gianlucarenzi/Vera-Module-RBL-A2/VGA-Extender/images/VGA-Extender-BOTTOM.png

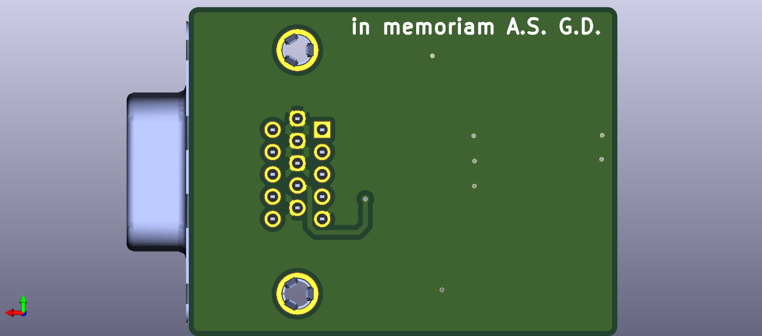
VGA-Extender/images/VGA-Extender-BOTTOM.png
