gianlucarenzi/Vera-Module-RBL-A2/VGA-Extender/images/VGA-Extender-TOP.png

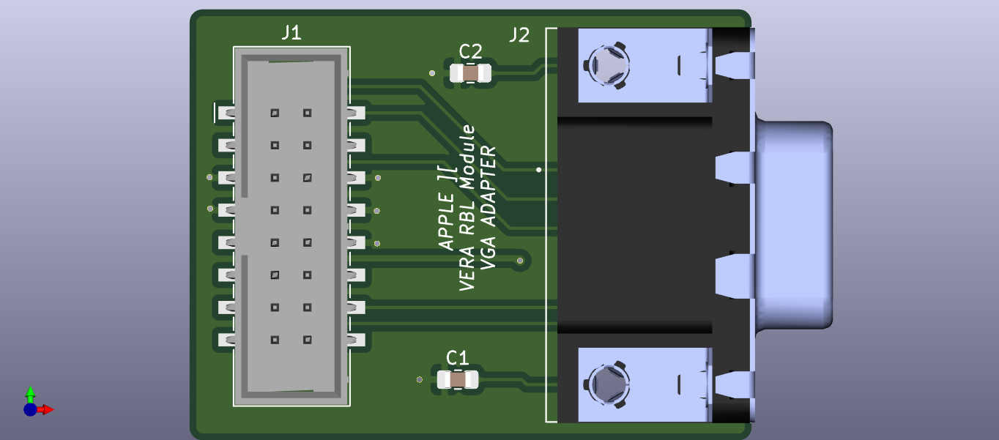
VGA-Extender/images/VGA-Extender-TOP.png
