gianlucarenzi/Vera-Module-RBL-A2/VGA-Extender/images/VGA-Extender.png

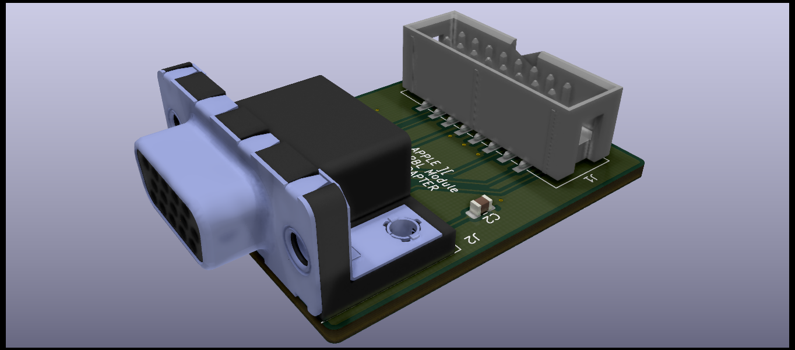
VGA-Extender/images/VGA-Extender.png
