gianlucarenzi/Vera-Module-RBL-A2/VERA-MODULE-RBL.csv

Comment | Designator | Footprint | LCSC
10uF | C13,C15,C17,C19,C21,C24 | Capacitor_SMD:C_0805_2012Metric_Pad1.18x1.45mm_HandSolder | C440198
100nF | C1,C2,C9,C10,C11,C12,C14,C16,C18,C20,C22,C23,C27,C28,C29,C38,C40,C42,C44,C46,C49,C50,C52,C57,C58,C61,C62,C63,C67,C68,C69,C70 | Capacitor_SMD:C_0805_2012Metric_Pad1.18x1.45mm_HandSolder | C840116
4.7uF | C26,C34,C35 | Capacitor_SMD:C_0805_2012Metric_Pad1.18x1.45mm_HandSolder | C7393930
2.2uF | C36 | Capacitor_SMD:C_0805_2012Metric_Pad1.18x1.45mm_HandSolder | C377773
22uF | C37 | Capacitor_SMD:C_0805_2012Metric_Pad1.18x1.45mm_HandSolder | C86817
1uF | C3,C4,C5,C6,C7,C8,C25,C30,C31,C32,C33,C43,C59,C60 | Capacitor_SMD:C_0805_2012Metric_Pad1.18x1.45mm_HandSolder | C2798196
10uF-35V | C47 | Capacitor_Tantalum_SMD:CP_EIA-3528-12_Kemet-T_Pad1.50x2.35mm_HandSolder | C8017
10uF-20V | C45,C48,C51 | Capacitor_Tantalum_SMD:CP_EIA-3528-12_Kemet-T_Pad1.50x2.35mm_HandSolder | C8017
27pF | C64,C65 | Capacitor_SMD:C_0805_2012Metric_Pad1.18x1.45mm_HandSolder | C1808
DIOSCH20V | D3,D4 | Diode_SMD:D_SMC_Handsoldering | C236151
Fiducial | FID1,FID2,FID3,FID4 | Fiducial:Fiducial_0.5mm_Mask1mm
MountingHole | H1,H2,H3,H4 | MountingHole:MountingHole_3.2mm_M3
CONN_SMD_HEADER_BOX_02x08_HX-JN2.54 | J1,J2 | RetroBitLab:IDC-Header_2x08_P2.54mm_Vertical_SMD | C41376031
CONN_DM3AT-SF-PEJM5 | J3 | RetroBitLab:HRS_DM3AT-SF-PEJM5 | C114218
DX07S016JA1R1500 | J4 | RetroBitLab:JAE_DX07S016JA1R1500 | C3197885
PJ-002AH-SMT-TR | J5 | RetroBitLab:CUI_PJ-002AH-SMT-TR | C22434687
CONN_SMD_01x08_Staggered_2.54mm | J6 | Connector_PinSocket_2.54mm:PinSocket_1x08_P2.54mm_Vertical_SMD_Pin1Right | C42380985
PJ-313D | J7 | RetroBitLab:jack_3.5_pj313d-smt | C668608
Bus_Apple_II_Card_Side | J8 | RetroBitLab:APPLE2-PERIPHERAL-BUS-EDGE
SolderJumper_2_Open | JP1,JP3 | Jumper:SolderJumper-2_P1.3mm_Open_RoundedPad1.0x1.5mm
Jumper_2_Open | JP2 | Connector_PinHeader_2.54mm:PinHeader_1x02_P2.54mm_Vertical
FB0805100R100MHZ4A | L1 | Inductor_SMD:L_0805_2012Metric_Pad1.15x1.40mm_HandSolder | C15957
IND0603600R100MHZ300mA | L2 | Inductor_SMD:L_0603_1608Metric_Pad1.05x0.95mm_HandSolder | C139271
Label-20mmx10mm | LBL1 | RetroBitLab:Label-20mmx10mm-Silkscreen
RED | LD1,LD3,LD5 | LED_SMD:LED_1206_3216Metric_Pad1.42x1.75mm_HandSolder | C965822
GREEN | LD2,LD4 | LED_SMD:LED_0805_2012Metric_Pad1.15x1.40mm_HandSolder | C84260
VERA X16 LOGO | LOGO1 | RetroBitLab:x16logo
RETROCAMPUS | LOGO2 | RetroBitLab:retrocampus_silkscreen_16.9mm_8.3mm
KiCAD DESIGN | LOGO3 | Symbol:KiCad-Logo2_6mm_SilkScreen
ESP32_BOBOARD | LOGO5 | RetroBitLab:ESP32_BOBOARD_5V_21.7mmx21.7mm
MOSFET-BSS138-SOT-23 | Q1 | Package_TO_SOT_SMD:SOT-23 | C82045
BC817,SOT-23 | Q3,Q4 | Package_TO_SOT_SMD:SOT-23 | C20069154
2K7 | R1 | Resistor_SMD:R_0805_2012Metric_Pad1.20x1.40mm_HandSolder | C313926
2K | R11,R13,R15 | Resistor_SMD:R_0805_2012Metric_Pad1.20x1.40mm_HandSolder | C114572
150R | R12,R14,R16 | Resistor_SMD:R_0805_2012Metric_Pad1.20x1.40mm_HandSolder | C17471
160R | R18,R20,R22 | Resistor_SMD:R_0805_2012Metric_Pad1.20x1.40mm_HandSolder | C2960793
910R | R17,R19,R21 | Resistor_SMD:R_0805_2012Metric_Pad1.20x1.40mm_HandSolder | C2930211
27R | R24,R26,R28 | Resistor_SMD:R_0805_2012Metric_Pad1.20x1.40mm_HandSolder | C17594
820R | R29,R30 | Resistor_SMD:R_0805_2012Metric_Pad1.20x1.40mm_HandSolder | C17837
50R | R3,R4 | Resistor_SMD:R_0805_2012Metric_Pad1.20x1.40mm_HandSolder | C2828866
330R | R32,R61 | Resistor_SMD:R_0805_2012Metric_Pad1.20x1.40mm_HandSolder | C313892
47K | R37,R38,R39,R40,R41,R42,R43,R44 | Resistor_SMD:R_0805_2012Metric_Pad1.20x1.40mm_HandSolder | C17713
560R | R45,R46,R67,R68 | Resistor_SMD:R_0805_2012Metric_Pad1.20x1.40mm_HandSolder | C28636
DNP | R49 | Resistor_SMD:R_1206_3216Metric_Pad1.30x1.75mm_HandSolder
10K | R5,R7,R34,R36,R47,R48,R53,R62,R63,R65,R69,R70,R71 | Resistor_SMD:R_0805_2012Metric_Pad1.20x1.40mm_HandSolder | C84376
5K1 | R50,R51 | Resistor_SMD:R_0805_2012Metric_Pad1.20x1.40mm_HandSolder | C27834
220R | R54 | Resistor_SMD:R_0805_2012Metric_Pad1.20x1.40mm_HandSolder | C5120092
2K2 | R52,R55 | Resistor_SMD:R_0805_2012Metric_Pad1.20x1.40mm_HandSolder | C17520
510R | R23,R25,R27,R57 | Resistor_SMD:R_0805_2012Metric_Pad1.20x1.40mm_HandSolder | C114563
330R | R58 | Resistor_SMD:R_0603_1608Metric_Pad0.98x0.95mm_HandSolder | C105881
4K7 | R31,R33,R59,R60 | Resistor_SMD:R_0805_2012Metric_Pad1.20x1.40mm_HandSolder | C17673
CREZ08051% | R2,R35,R56,R64,R72,R73,R74 | Resistor_SMD:R_0805_2012Metric_Pad1.20x1.40mm_HandSolder | C328378
4K3 | R8,R9,R10 | Resistor_SMD:R_0805_2012Metric_Pad1.20x1.40mm_HandSolder | C17667
SPST2P | SW1,SW3 | RetroBitLab:SPST-7.3x3.9x2.5-WUERTH-434121025816 | C318911
TP5V | TP1 | TestPoint:TestPoint_Pad_D2.0mm
W25Q16JVSNIQ | U10 | Package_SO:SOIC-8_3.9x4.9mm_P1.27mm | C2456211
WM8524CGEDT | U11 | Package_SO:TSSOP-16_4.4x5mm_P0.65mm | C146242
USBCH340C | U12 | RetroBitLab:SOIC-16_3.9x9.9mm_P1.27mm | C84681
AMS1117-3.3 | U13 | Package_TO_SOT_SMD:SOT-223-3_TabPin2 | C6186
AMS1117-1.2 | U14 | Package_TO_SOT_SMD:SOT-223-3_TabPin2 | C347218
L7805 | U15 | Package_TO_SOT_SMD:TO-252-2 | C110908
MAX40200AUK | U17,U18 | Package_TO_SOT_SMD:SOT-23-5 | C47118006
ICE40UP5K-SG48ITR | U2 | RetroBitLab:QFN-48-1EP_7x7mm_P0.5mm_EP5.6x5.6mm | C2678152
SN74HCT04DR | U23 | Package_SO:SOIC-14_3.9x8.7mm_P1.27mm | C6766
SN74LVC00 | U24,U25 | Package_SO:TSSOP-14_4.4x5mm_P0.65mm | C7803
SN74LVC1G07DBVR | U26,U27 | Package_TO_SOT_SMD:SOT-23-5 | C7829
74LVC4245APW_118 | U3,U4,U6,U19 | RetroBitLab:IC_74LVC4245_SOP65P640X110-24N | C6091
IC74HC00 | U5 | Package_SO:SOIC-14_3.9x8.7mm_P1.27mm | C5586
ESP32-S3FN8 | U7 | RetroBitLab:IC_ESP32-S3FN8-QFN40P700X700X90-57N | C2913196
74CBTLV3126PW,118 | U8 | Package_SO:TSSOP-14_4.4x5mm_P0.65mm | C543078
CD4011B | U9 | Package_SO:SOIC-14_3.9x8.7mm_P1.27mm | C194334
OT3EL89CJI-111YLC-25M | X1 | RetroBitLab:OSC_ECS-2033-250-BN | C7471623
40.000Mhz | Y2 | Crystal:Crystal_SMD_2520-4Pin_2.5x2.0mm | C284176
TestPoint | mIOSEL1 | TestPoint:TestPoint_Pad_D2.0mm
