gianlucarenzi/Vera-Module-RBL-A2/(list of files, cad)

Other CAD files:
images/VERA-MODULE-RBL.step
