gianlucarenzi/Vera-Module-RBL-A2/VERA-MODULE-RBL.pdf

## Sheet: VeraModule

## Sheet: BusDecoder

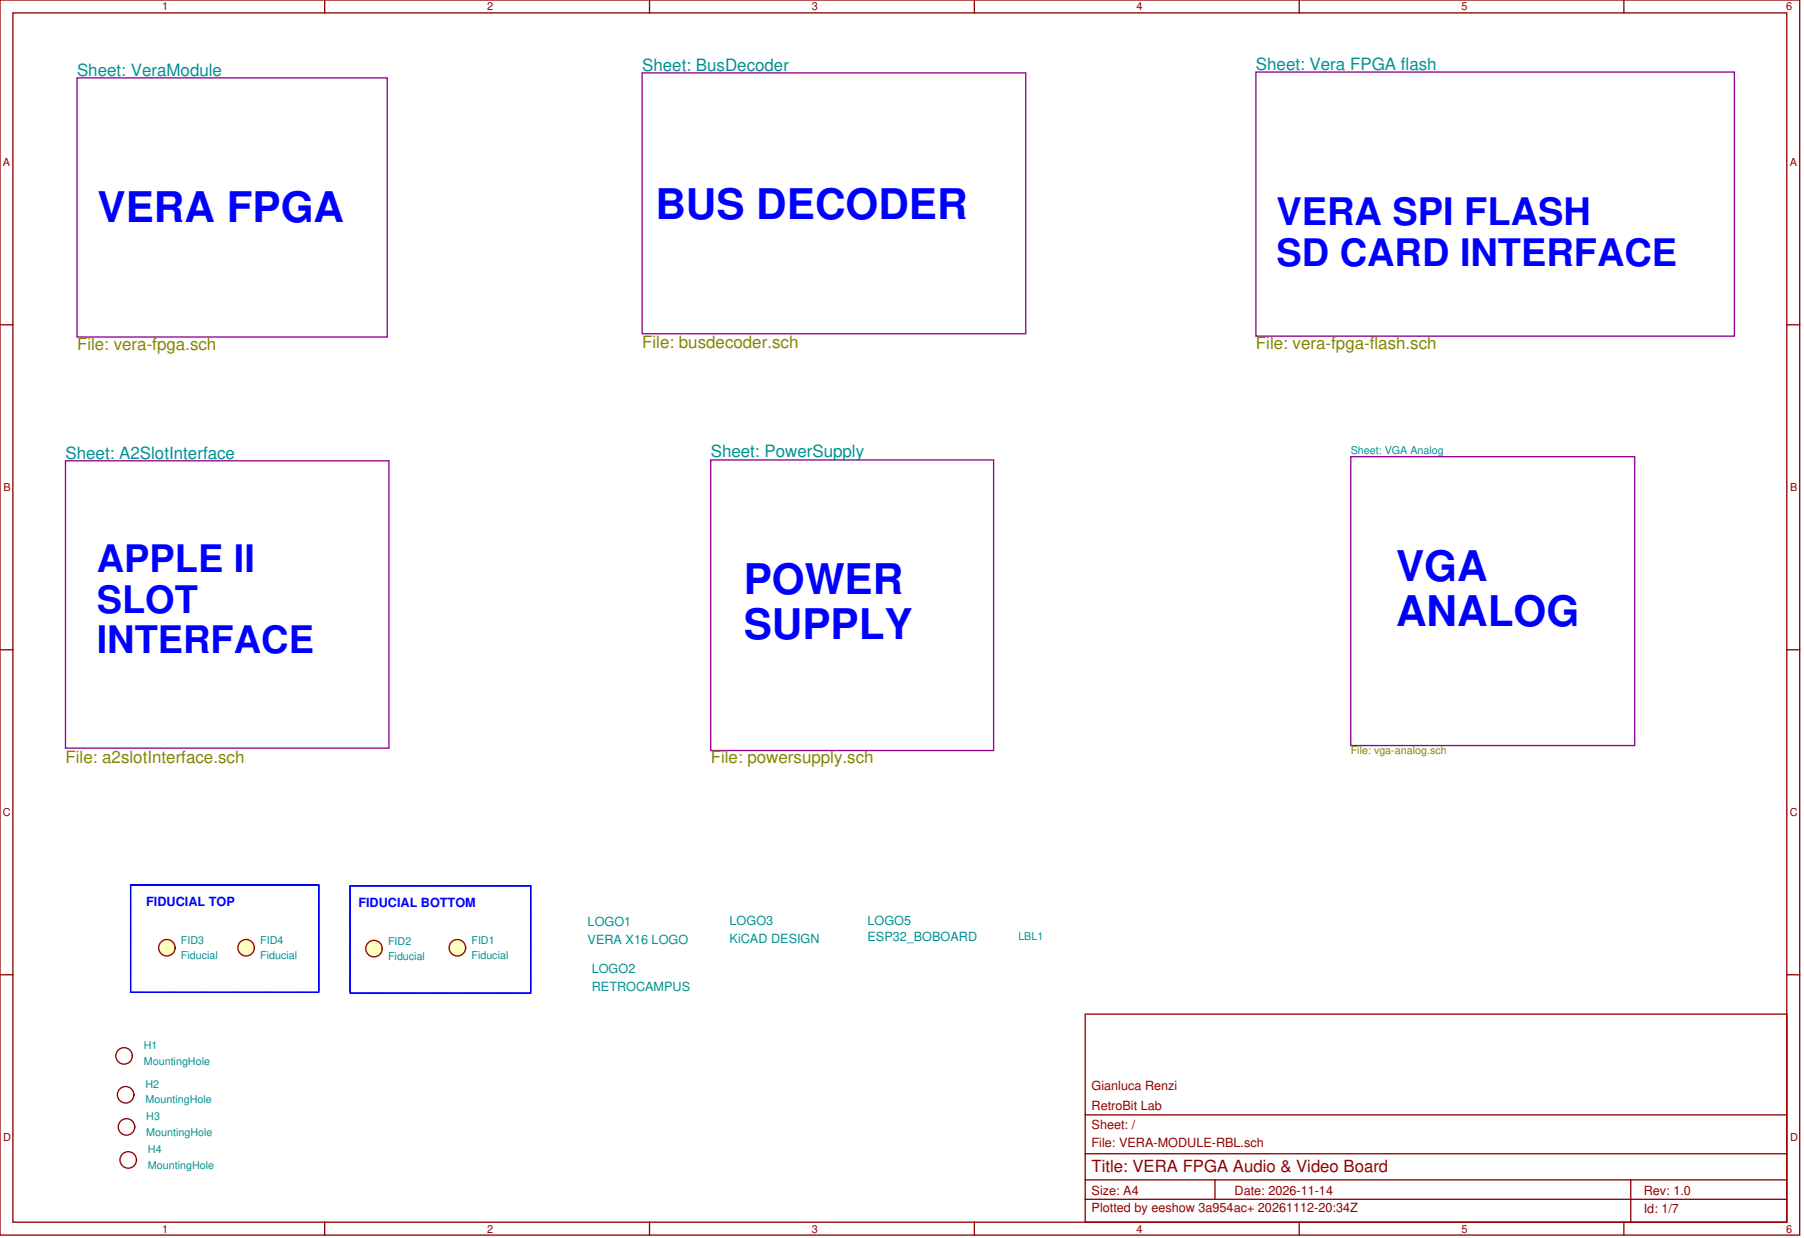
[picture p10: page 1]
Size: A4; Rev: 1.0; Date: 2026-11-14; Sheet: A2SlotInterface; File: a2slotInterface.sch; Sheet: PowerSupply; Fiducial; FID3; FID4; FID2; FID1; VERA X16 LOGO; LOGO1; KiCAD DESIGN; LOGO3; ESP32_BOBOARD; LOGO5; LBL1; MountingHole; RETROCAMPUS; LOGO2; VERA FPGA; BUS DECODER; APPLE II SLOT INTERFACE; POWER SUPPLY; FIDUCIAL TOP; FIDUCIAL BOTTOM; VGA ANALOG

Sheet: Vera FPGA flash

VERA SPI FLASH
SD CARD INTERFACE

File: vera-fpga.sch

File: busdecoder.sch

File: vera-fpga-flash.sch

Sheet: VGA Analog

File: powersupply.sch

File: vga-analog.sch

Gianluca Renzi
RetroBit Lab
Sheet: /
File: VERA-MODULE-RBL.sch
Title: VERA FPGA Audio & Video Board

Plotted by eeshow 3a954ac+ 20261112-20:34Z

# IOT_43a 32 VCCIO_0 33

# FPGA VERA LOGIC VIDEO & AUDIO CARD

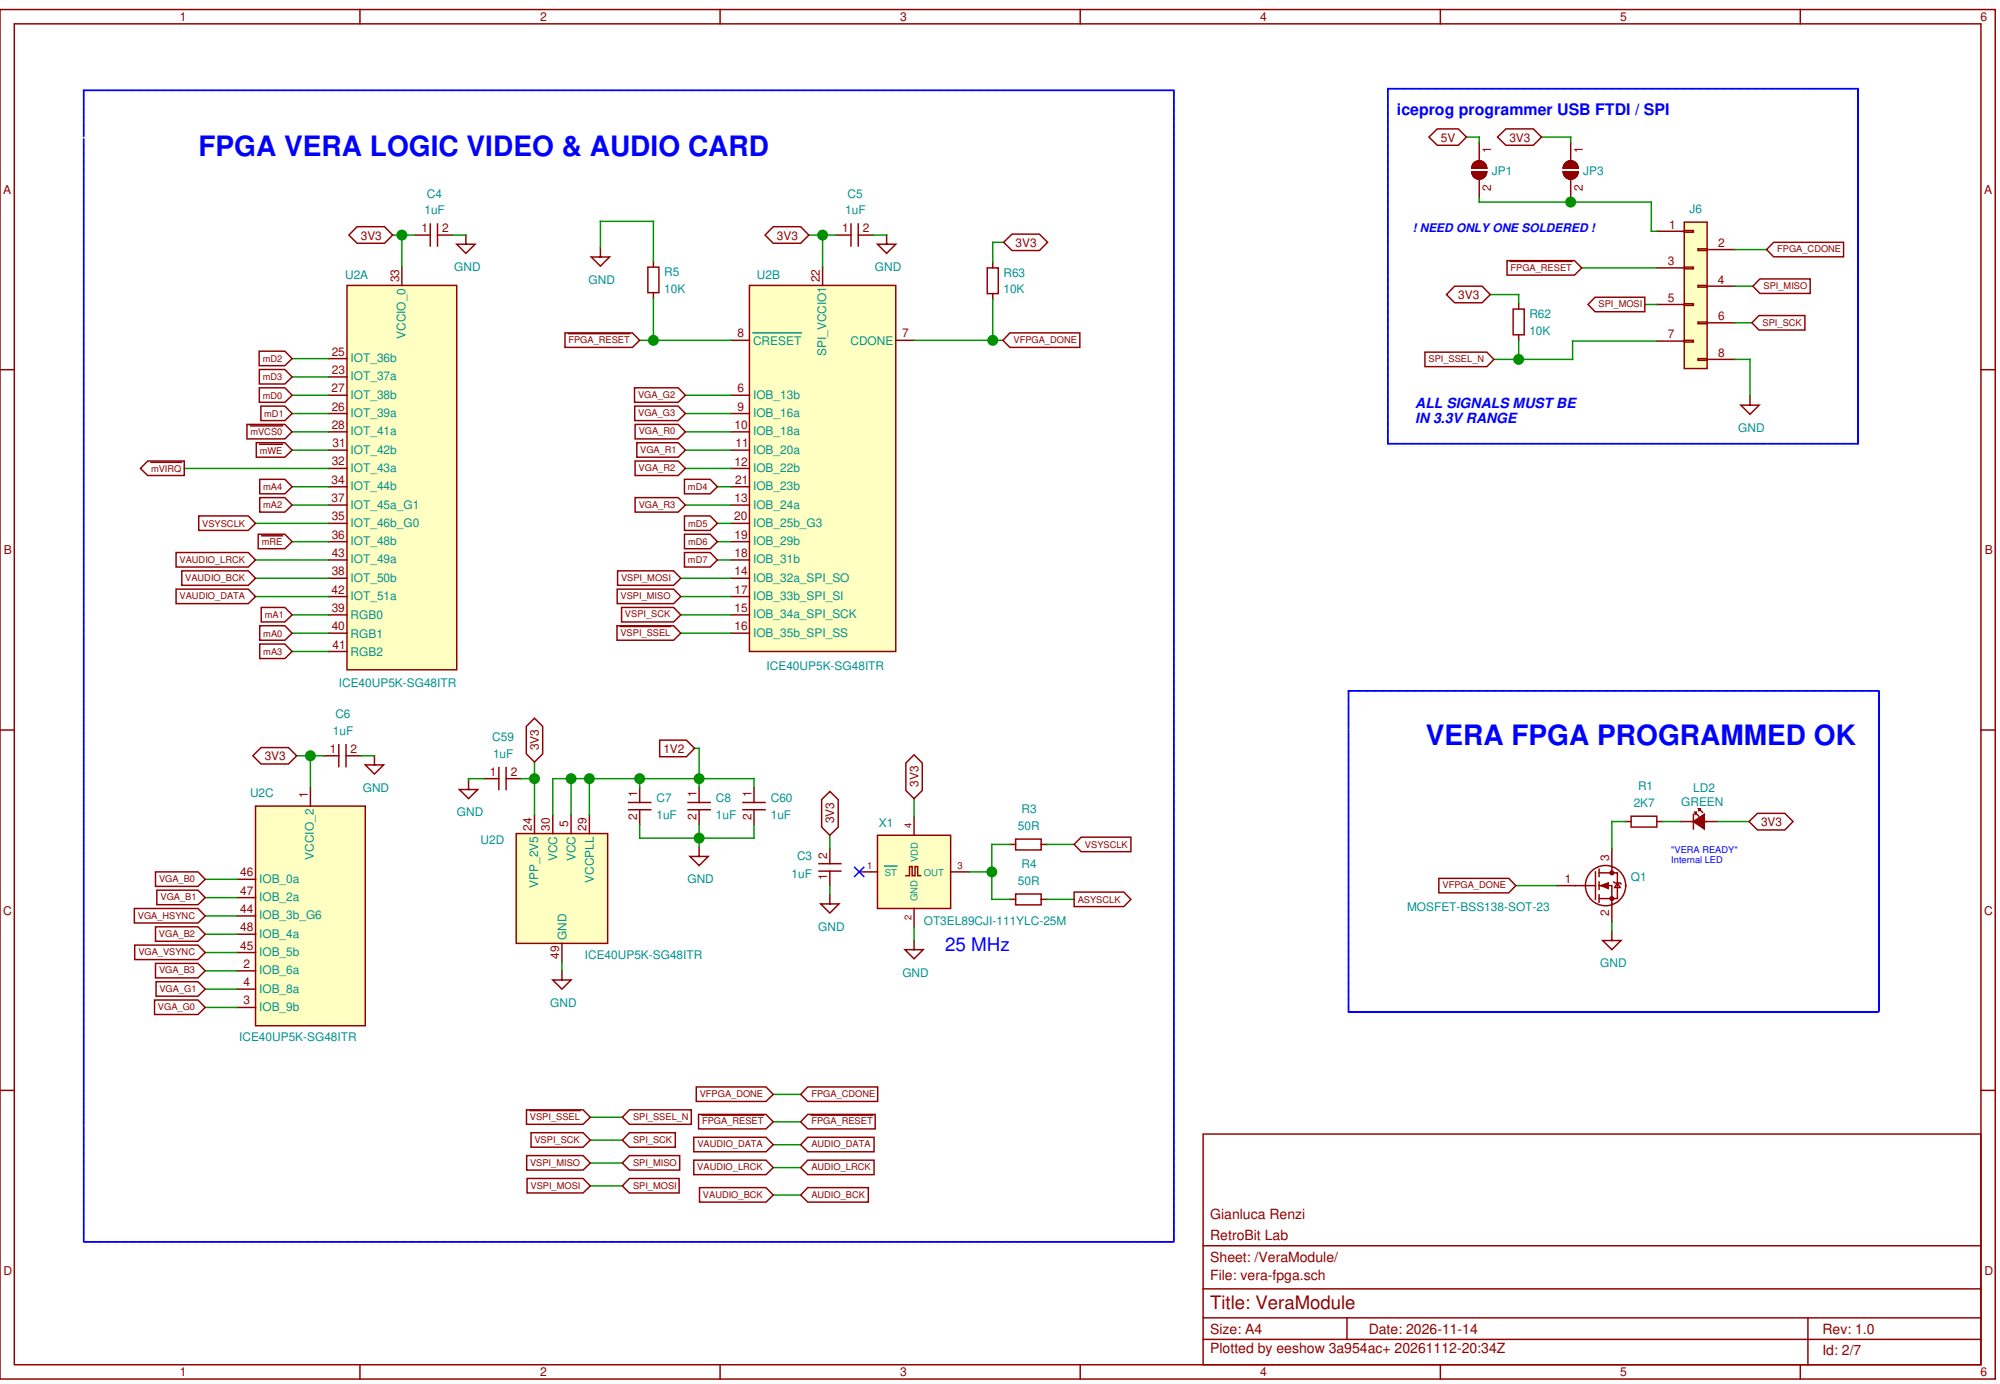
[picture p11: page 2]

iceprog programmer USB FTDI / SPI

! NEED ONLY ONE SOLDERED !

ALL SIGNALS MUST BE
IN 3.3V RANGE

VERA FPGA PROGRAMMED OK

Gianluca Renzi
RetroBit Lab
Sheet: /VeraModule/
File: vera-fpga.sch
Title: VeraModule

# SLOT NUMBER: decoded by the Apple (/DEVSEL, /IOSEL)

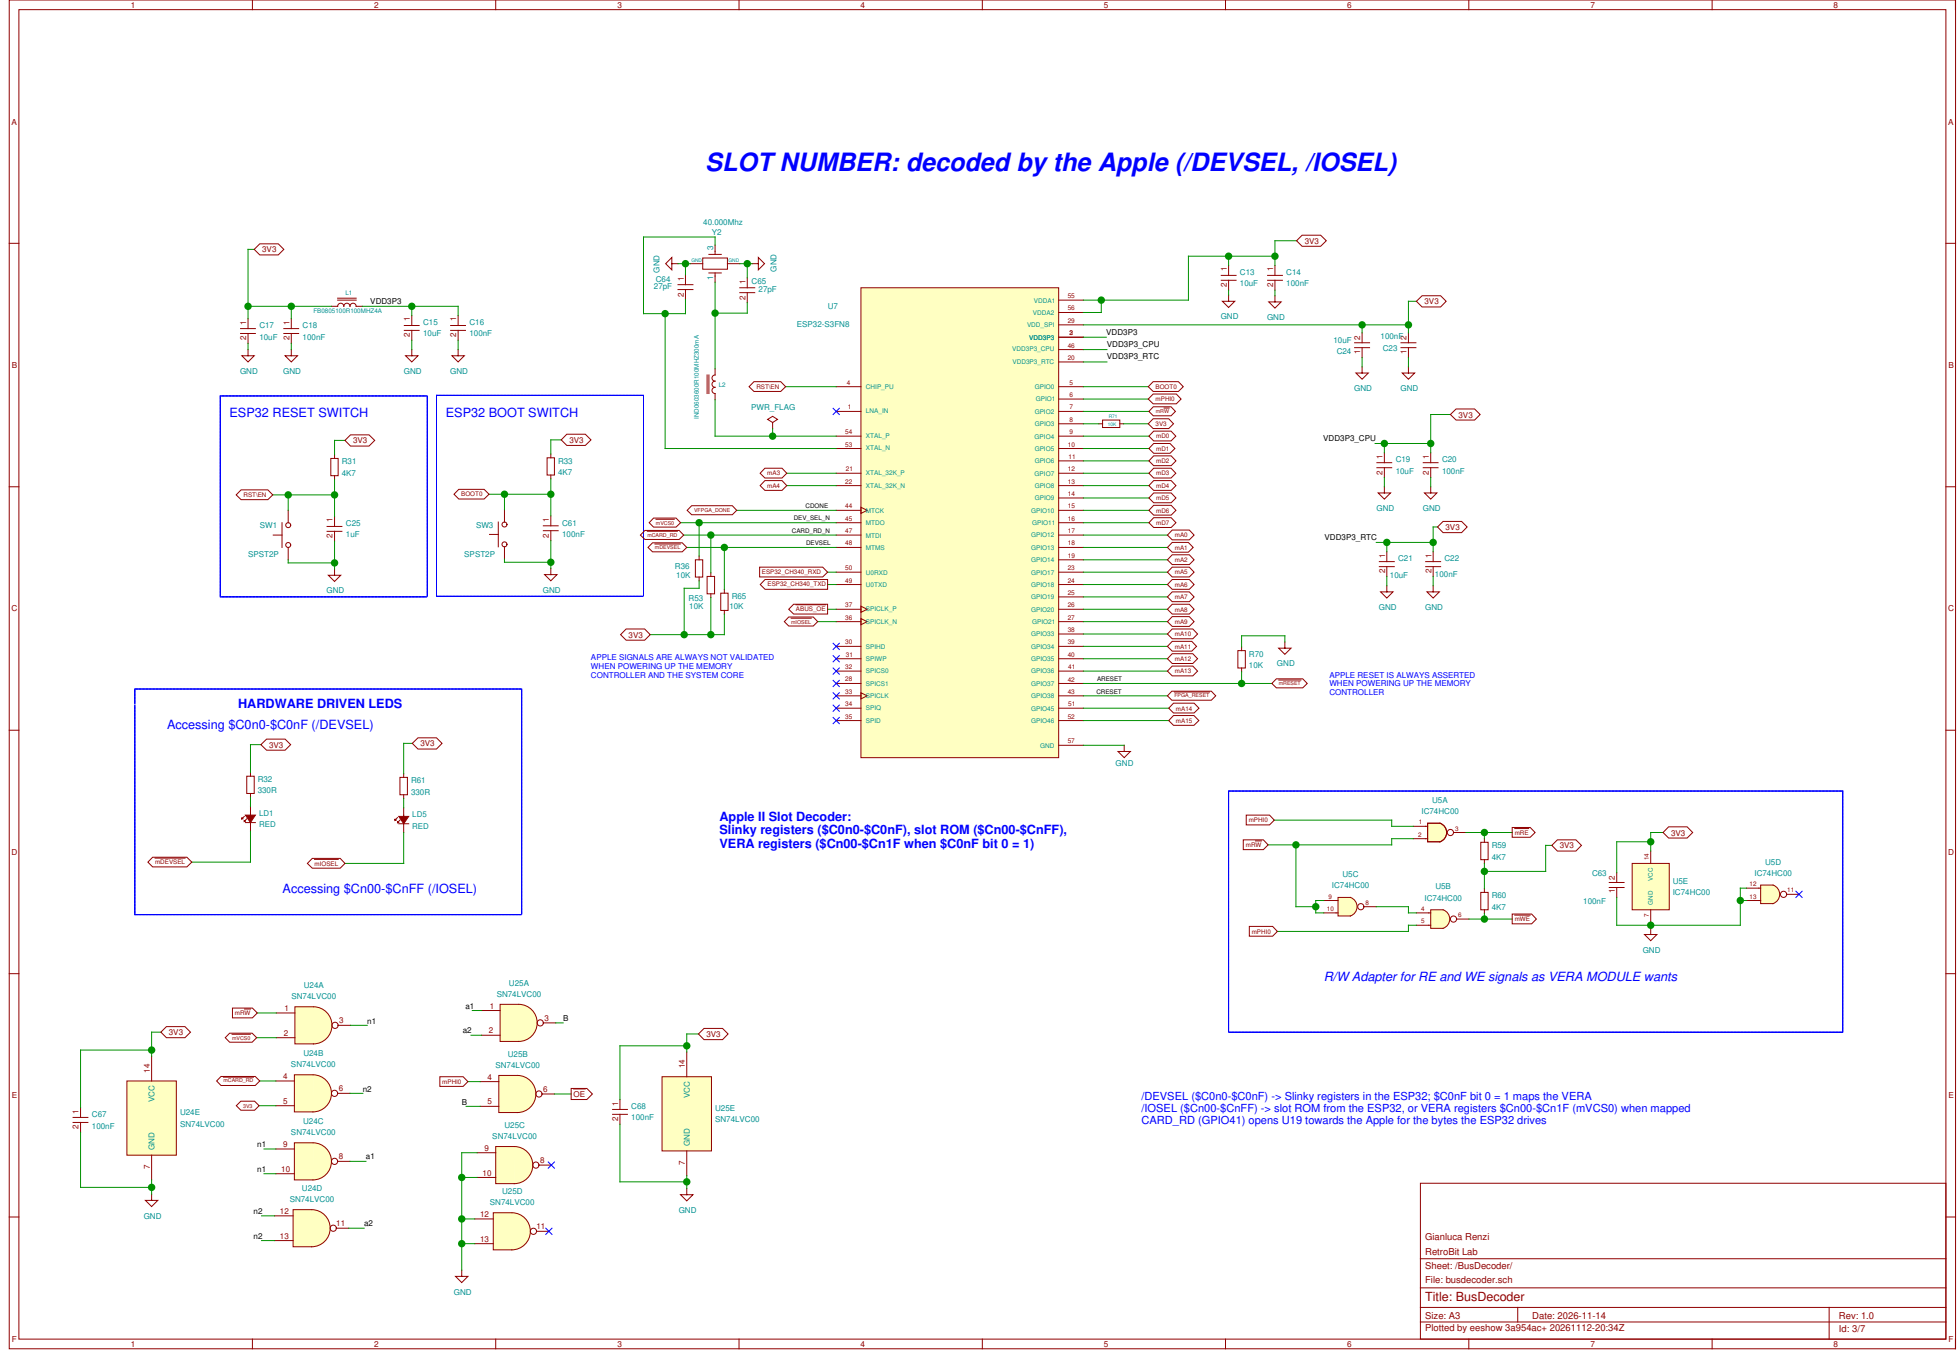
[picture p12: page 3]

APPLE SIGNALS ARE ALWAYS NOT VALIDATED
WHEN POWERING UP THE MEMORY
CONTROLLER AND THE SYSTEM CORE

APPLE RESET IS ALWAYS ASSERTED
CONTROLLER

Apple II Slot Decoder:
Slinky registers ($C0n0-$C0nF), slot ROM ($Cn00-$CnFF),
VERA registers ($Cn00-$Cn1F when $C0nF bit 0 = 1)

R/W Adapter for RE and WE signals as VERA MODULE wants

/DEVSEL ($C0n0-$C0nF) -> Slinky registers in the ESP32; $C0nF bit 0 = 1 maps the VERA
/IOSEL ($Cn00-$CnFF) -> slot ROM from the ESP32, or VERA registers $Cn00-$Cn1F (mVCS0) when mapped
CARD_RD (GPIO41) opens U19 towards the Apple for the bytes the ESP32 drives

# DMA_OUT 24 +5V ²⁵ GND 26

# D7 42 D6 43 D5 44 D4 45 D3 46 D2 47 D1 48 D0 49

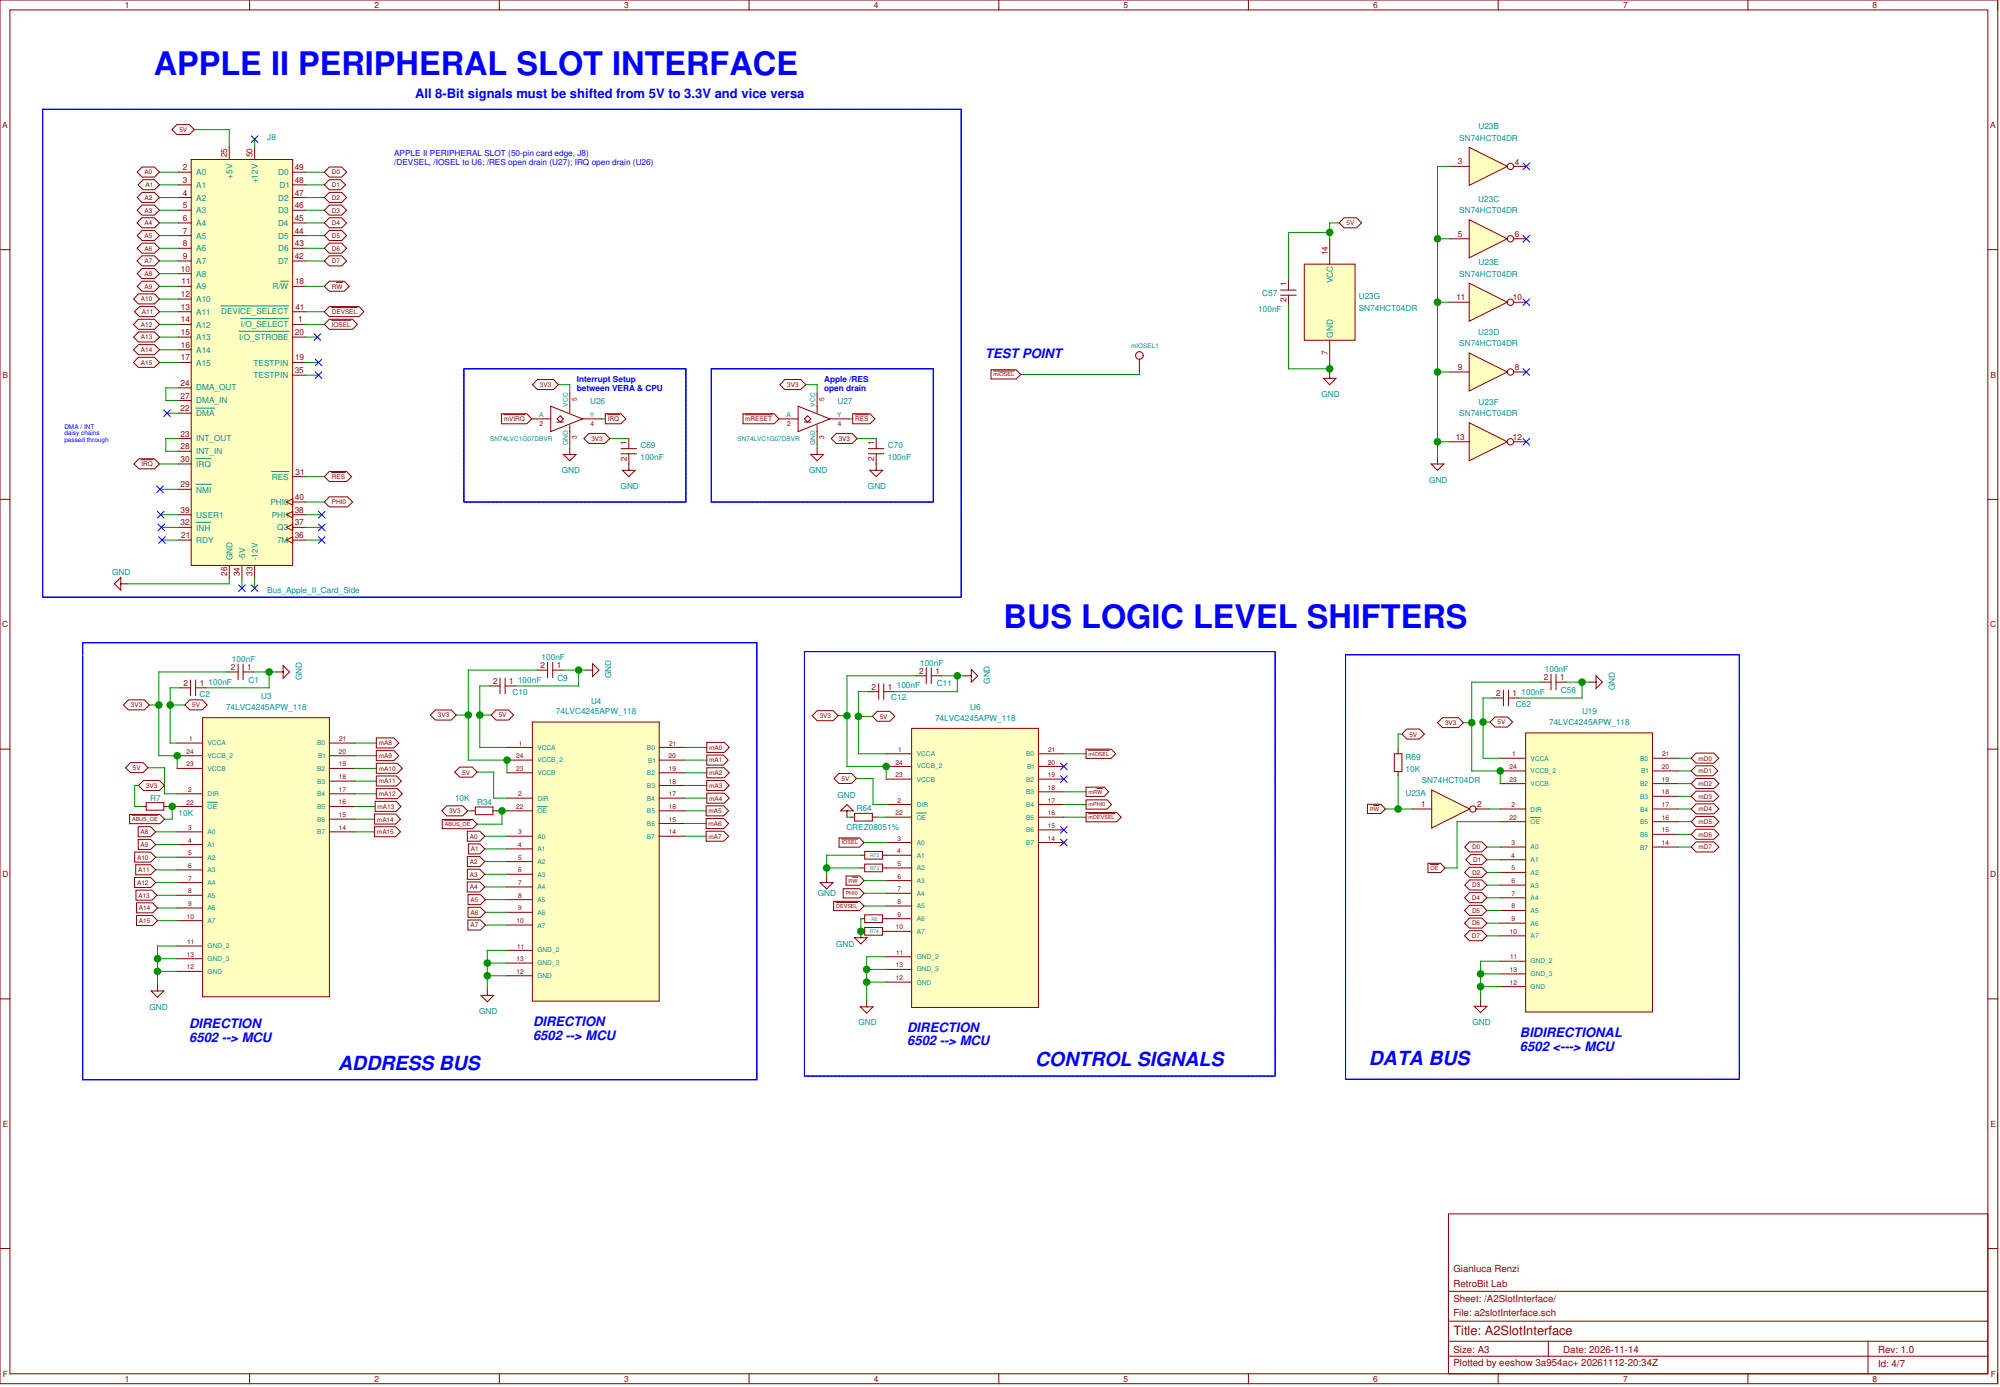
[picture p13: page 4]

APPLE II PERIPHERAL SLOT INTERFACE

All 8-Bit signals must be shifted from 5V to 3.3V and vice versa

APPLE II PERIPHERAL SLOT (50-pin card edge, J8)
/DEVSEL, /IOSEL to U6; /RES open drain (U27); IRQ open drain (U26)

BUS LOGIC LEVEL SHIFTERS

# FPGA/SSD Flash Glue Logic

When programming SPI FLASH for bitstream,

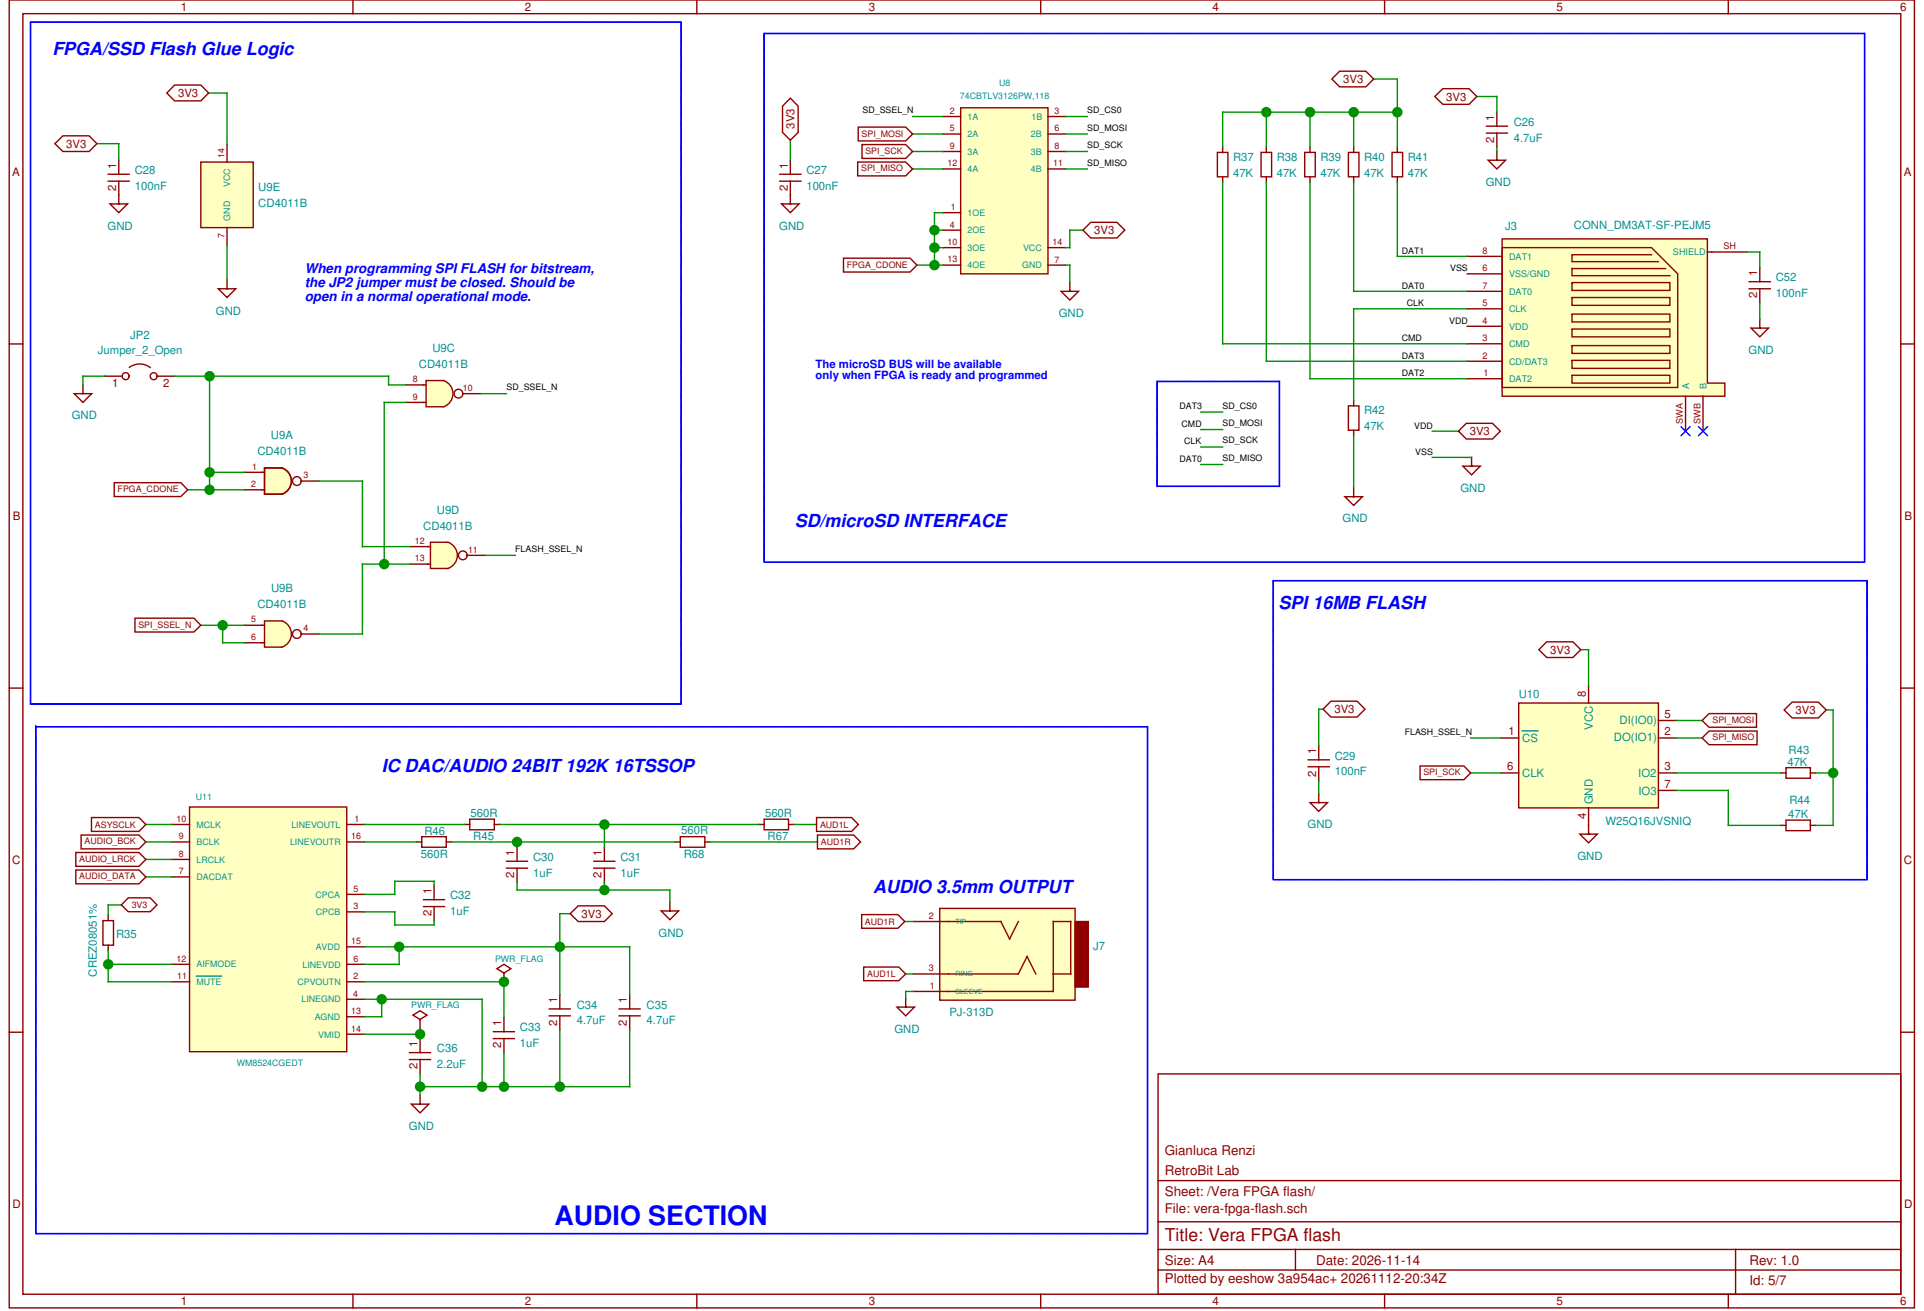
[picture p14: page 5]

the JP2 jumper must be closed. Should be
open in a normal operational mode.

The microSD BUS will be available
only when FPGA is ready and programmed

DAT3 | CD/DAT3 2

DAT2

Gianluca Renzi
RetroBit Lab
Sheet: /Vera FPGA flash/
File: vera-fpga-flash.sch
Title: Vera FPGA flash

# USB ESP32 PROGRAMMING

# POWER LED

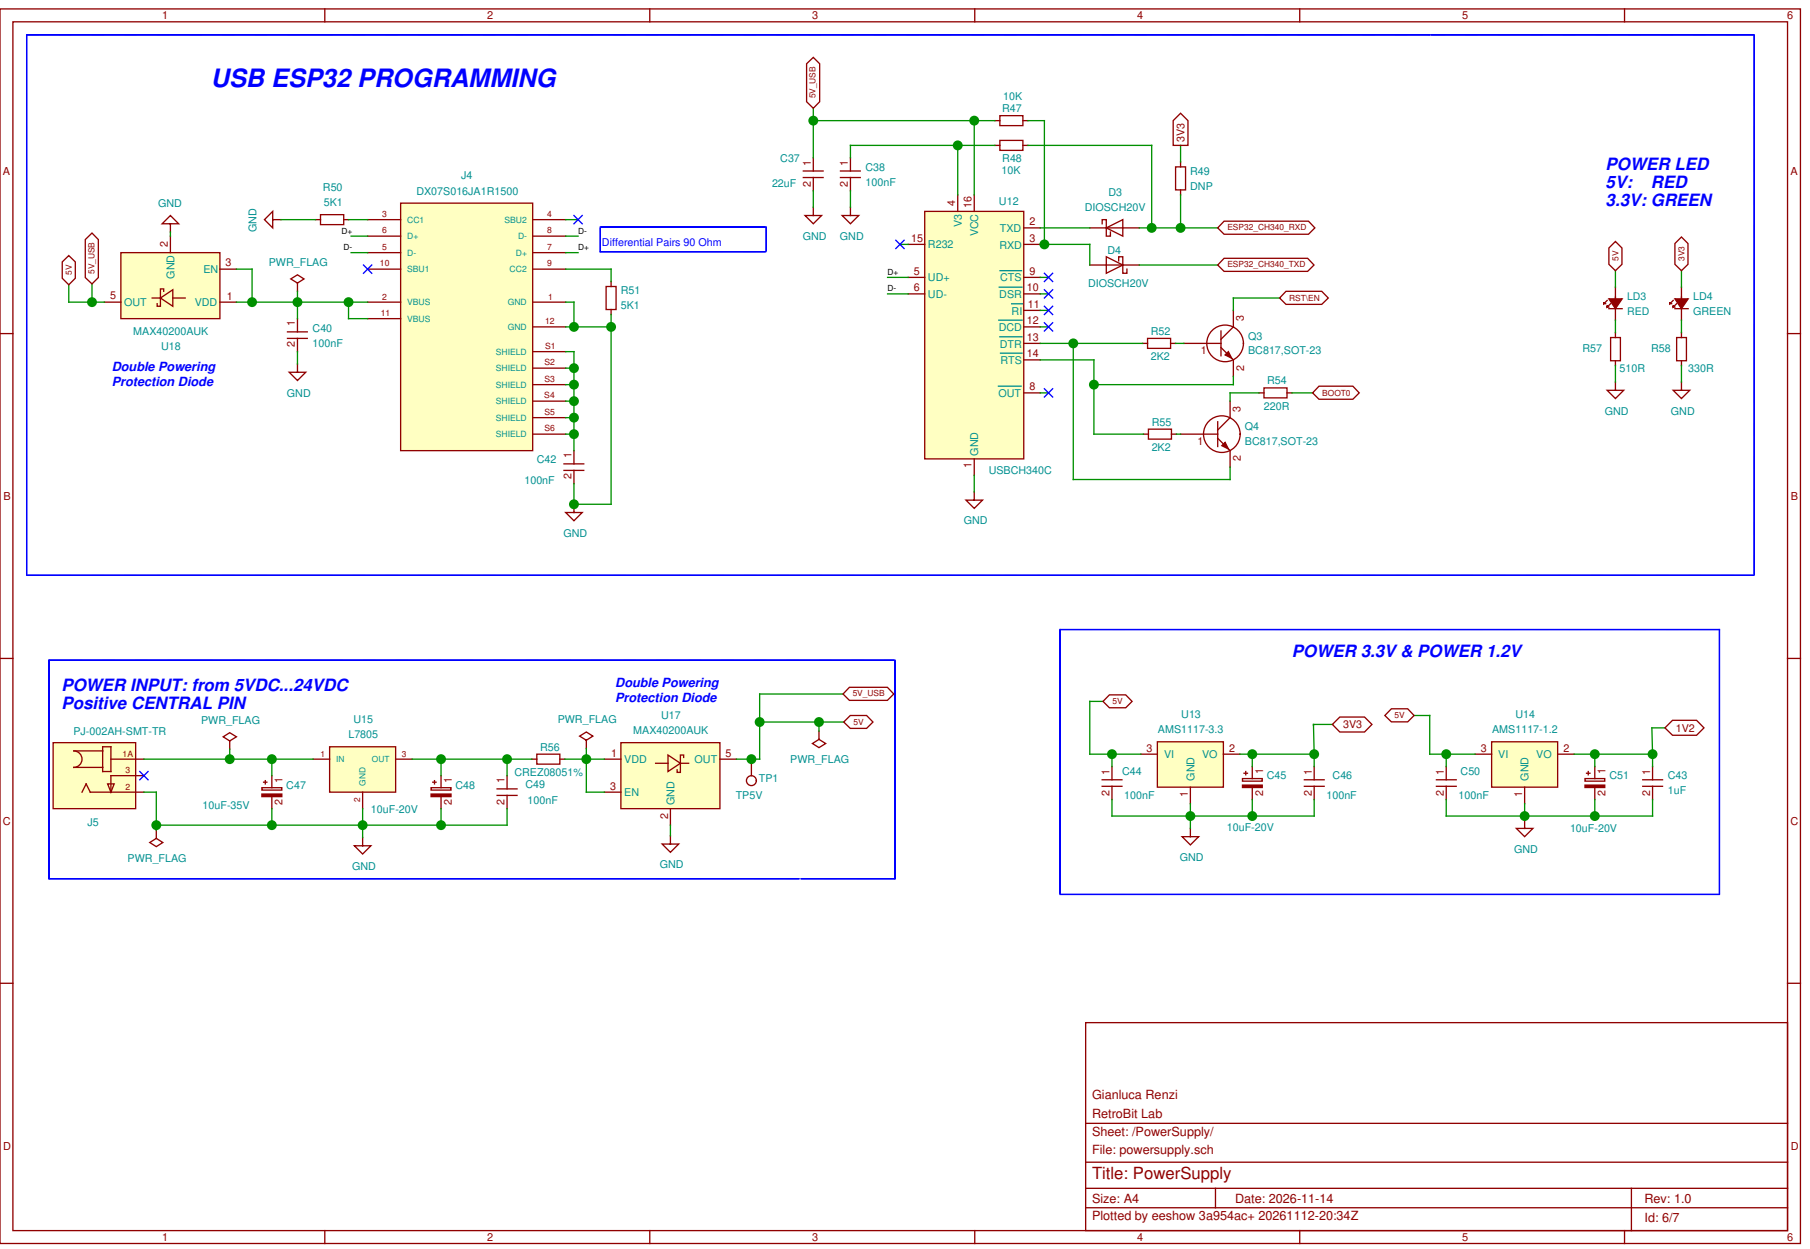
[picture p15: page 6]

# ANALOG VGA SIGNALS

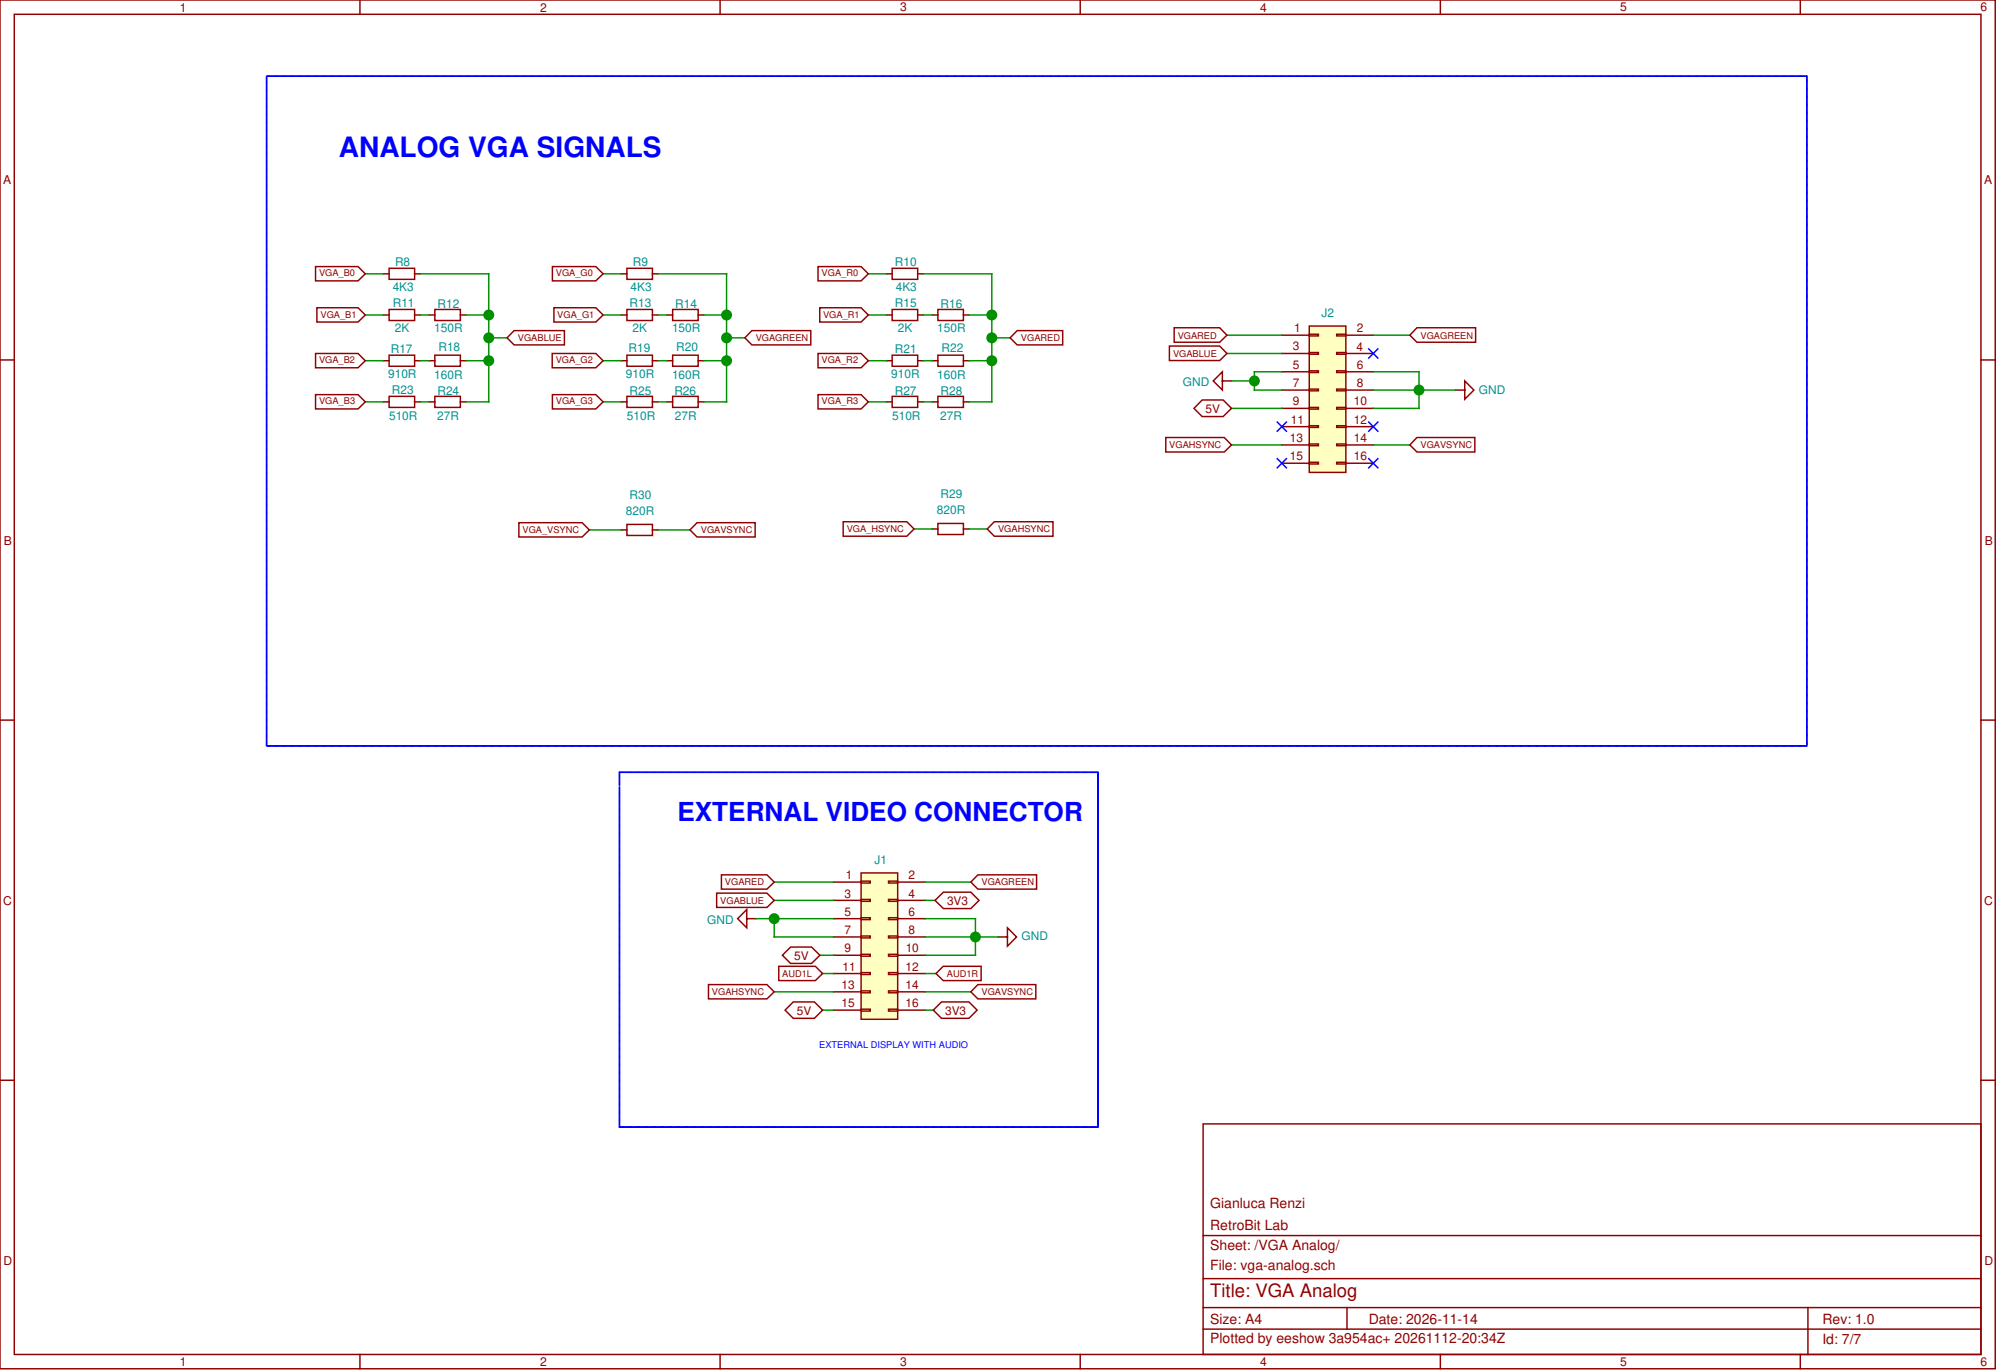
[picture p16: page 7]

EXTERNAL DISPLAY WITH AUDIO

Gianluca Renzi
RetroBit Lab
Sheet: /VGA Analog/
File: vga-analog.sch
Title: VGA Analog
