gianlucarenzi/Vera-Module-RBL-A2/WeACT-Studio-ESP32_S3_A_Sch.pdf

## GND

## VCC_3V3 1

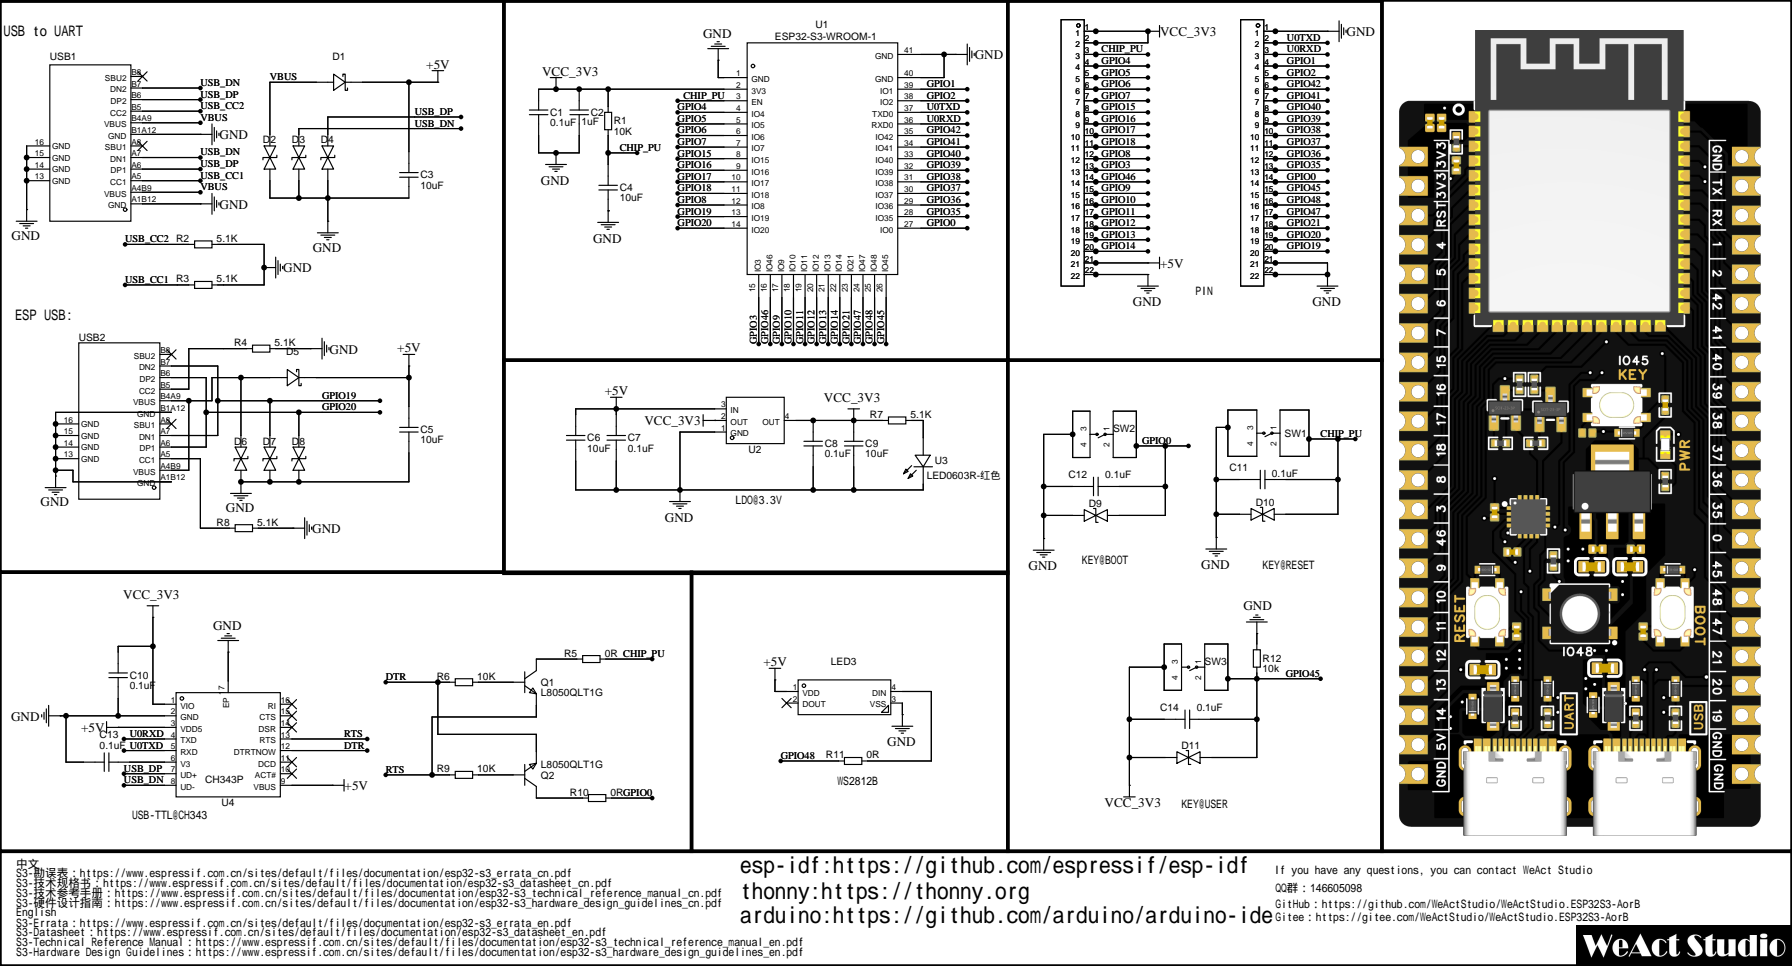
[picture p17: page 1]

IO0 27 IO⁴⁵ 26 IO⁴⁸ 25 IO⁴⁷ 24 IO²¹ 23 IO¹⁴ 22 IO¹³ 21 IO¹² 20 IO¹¹ 19 IO¹⁰ 18 IO⁹ 17 IO⁴⁶ 16 IO³ 15

ACT# 10 DCD 11 DTRTNOW 12 RTS 13 DSR 14 CTS 15 RI 16

esp-idf:https://github.com/espressif/esp-idf If you have any questions, you can contact WeAct Studio
thonny:https://thonny.org
arduino:https://github.com/arduino/arduino-ide

S3-勘误表：https://www.espressif.com.cn/sites/default/files/documentation/esp32-s3_errata_cn.pdf
S3-技术规格书：https://www.espressif.com.cn/sites/default/files/documentation/esp32-s3_datasheet_cn.pdf S3-技术参考手册：https://www.espressif.com.cn/sites/default/files/documentation/esp32-s3_technical_reference_manual_cn.pdf
S3-硬件设计指南：https://www.espressif.com.cn/sites/default/files/documentation/esp32-s3_hardware_design_guidelines_cn.pdf
English
S3-Errata：https://www.espressif.com.cn/sites/default/files/documentation/esp32-s3_errata_en.pdf
S3-Datasheet：https://www.espressif.com.cn/sites/default/files/documentation/esp32-s3_datasheet_en.pdf
S3-Technical Reference Manual：https://www.espressif.com.cn/sites/default/files/documentation/esp32-s3_technical_reference_manual_en.pdf
S3-Hardware Design Guidelines：https://www.espressif.com.cn/sites/default/files/documentation/esp32-s3_hardware_design_guidelines_en.pdf

QQ群：146605098
GitHub：https://github.com/WeActStudio/WeActStudio.ESP32S3-AorB
Gitee：https://gitee.com/WeActStudio/WeActStudio.ESP32S3-AorB
