gianlucarenzi/Vera-Module-RBL-A2/(list of files, drawings)

Other design files:
routing/board_pv.dsn
