gianlucarenzi/Vera-Module-RBL-A2/VERA-MODULE-RBL.kicad_pcb

## KiCad design VERA-MODULE-RBL.kicad_pcb (2026-11-14)

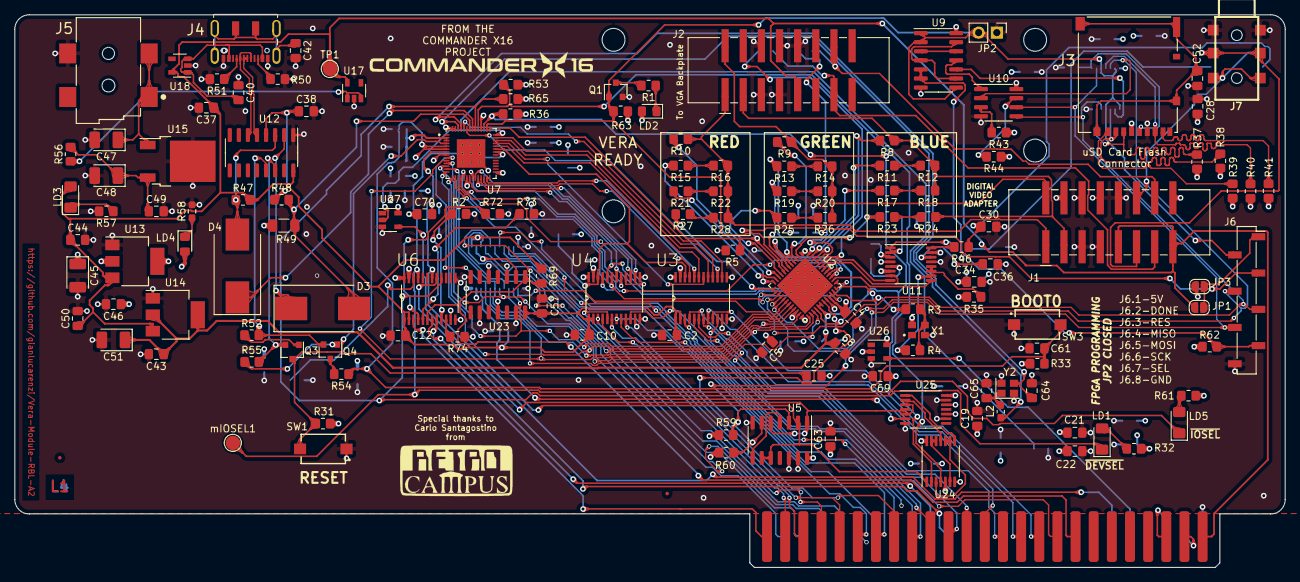
[picture p18: board VERA-MODULE-RBL.kicad_pcb from above]

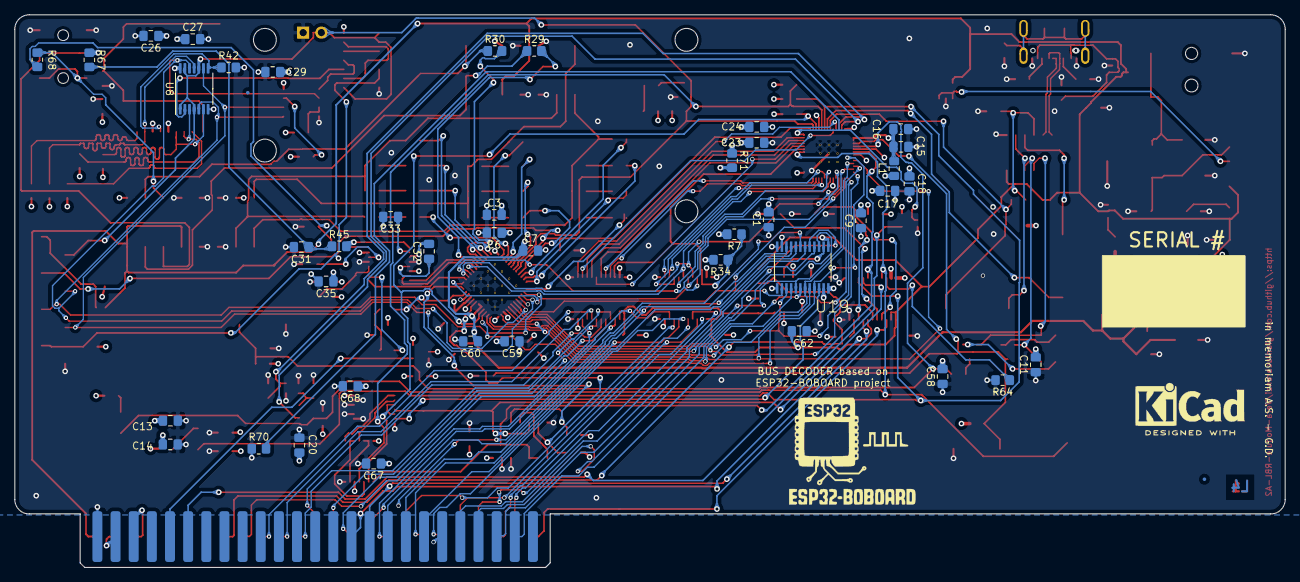
[picture p19: board VERA-MODULE-RBL.kicad_pcb from below]

Board: 4 copper layers, 177.8 x 77.3 mm, 199 parts (47 on the bottom side), 181 nets.

Parts:
C1, C2, C9, C10, C11, C12, C14, C16, C18, C20, C22, C23, C27, C28, C29, C38, C40, C42, C44, C46, C49, C50, C52, C57, C58, C61, C62, C63, C67, C68, C69, C70: 100nF; C_0805_2012Metric_Pad1.18x1.45mm_HandSolder
C3, C4, C5, C6, C7, C8, C25, C30, C31, C32, C33, C43, C59, C60: 1uF; C_0805_2012Metric_Pad1.18x1.45mm_HandSolder
C13, C15, C17, C19, C21, C24: 10uF; C_0805_2012Metric_Pad1.18x1.45mm_HandSolder
C26, C34, C35: 4.7uF; C_0805_2012Metric_Pad1.18x1.45mm_HandSolder
C36: 2.2uF; C_0805_2012Metric_Pad1.18x1.45mm_HandSolder
C37: 22uF; C_0805_2012Metric_Pad1.18x1.45mm_HandSolder
C45, C48, C51: 10uF-20V; CP_EIA-3528-12_Kemet-T_Pad1.50x2.35mm_HandSolder
C47: 10uF-35V; CP_EIA-3528-12_Kemet-T_Pad1.50x2.35mm_HandSolder
C64, C65: 27pF; C_0805_2012Metric_Pad1.18x1.45mm_HandSolder
D3, D4: DIOSCH20V; D_SMC_Handsoldering
FID1, FID2, FID3, FID4: Fiducial; Fiducial_0.5mm_Mask1mm
H1, H2, H3, H4: MountingHole; MountingHole_3.2mm_M3
J1, J2: CONN_SMD_HEADER_BOX_02x08_HX-JN2.54; IDC-Header_2x08_P2.54mm_Vertical_SMD
J3: CONN_DM3AT-SF-PEJM5; HRS_DM3AT-SF-PEJM5
J4: DX07S016JA1R1500; JAE_DX07S016JA1R1500
J5: PJ-002AH-SMT-TR; CUI_PJ-002AH-SMT-TR
J6: CONN_SMD_01x08_Staggered_2.54mm; PinSocket_1x08_P2.54mm_Vertical_SMD_Pin1Right
J7: PJ-313D; jack_3.5_pj313d-smt
J8: Bus_Apple_II_Card_Side; APPLE2-PERIPHERAL-BUS-EDGE
JP1, JP3: SolderJumper_2_Open; SolderJumper-2_P1.3mm_Open_RoundedPad1.0x1.5mm
JP2: Jumper_2_Open; PinHeader_1x02_P2.54mm_Vertical
L1: FB0805100R100MHZ4A; L_0805_2012Metric_Pad1.15x1.40mm_HandSolder
L2: IND0603600R100MHZ300mA; L_0603_1608Metric_Pad1.05x0.95mm_HandSolder
LBL1: Label-20mmx10mm; Label-20mmx10mm-Silkscreen
LD1, LD3, LD5: RED; LED_1206_3216Metric_Pad1.42x1.75mm_HandSolder
LD2, LD4: GREEN; LED_0805_2012Metric_Pad1.15x1.40mm_HandSolder
LOGO1: VERA X16 LOGO; x16logo
LOGO2: RETROCAMPUS; retrocampus_silkscreen_16.9mm_8.3mm
LOGO3: KiCAD DESIGN; KiCad-Logo2_6mm_SilkScreen
LOGO5: ESP32_BOBOARD; ESP32_BOBOARD_5V_21.7mmx21.7mm
Q1: MOSFET-BSS138-SOT-23; SOT-23
Q3, Q4: BC817,SOT-23; SOT-23
R1: 2K7; R_0805_2012Metric_Pad1.20x1.40mm_HandSolder
R2, R35, R56, R64, R72, R73, R74: CREZ08051%; R_0805_2012Metric_Pad1.20x1.40mm_HandSolder
R3, R4: 50R; R_0805_2012Metric_Pad1.20x1.40mm_HandSolder
R5, R7, R34, R36, R47, R48, R53, R62, R63, R65, R69, R70, R71: 10K; R_0805_2012Metric_Pad1.20x1.40mm_HandSolder
R8, R9, R10: 4K3; R_0805_2012Metric_Pad1.20x1.40mm_HandSolder
R11, R13, R15: 2K; R_0805_2012Metric_Pad1.20x1.40mm_HandSolder
R12, R14, R16: 150R; R_0805_2012Metric_Pad1.20x1.40mm_HandSolder
R17, R19, R21: 910R; R_0805_2012Metric_Pad1.20x1.40mm_HandSolder
R18, R20, R22: 160R; R_0805_2012Metric_Pad1.20x1.40mm_HandSolder
R23, R25, R27, R57: 510R; R_0805_2012Metric_Pad1.20x1.40mm_HandSolder
R24, R26, R28: 27R; R_0805_2012Metric_Pad1.20x1.40mm_HandSolder
R29, R30: 820R; R_0805_2012Metric_Pad1.20x1.40mm_HandSolder
R31, R33, R59, R60: 4K7; R_0805_2012Metric_Pad1.20x1.40mm_HandSolder
R32, R61: 330R; R_0805_2012Metric_Pad1.20x1.40mm_HandSolder
R37, R38, R39, R40, R41, R42, R43, R44: 47K; R_0805_2012Metric_Pad1.20x1.40mm_HandSolder
R45, R46, R67, R68: 560R; R_0805_2012Metric_Pad1.20x1.40mm_HandSolder
R49: DNP; R_1206_3216Metric_Pad1.30x1.75mm_HandSolder
R50, R51: 5K1; R_0805_2012Metric_Pad1.20x1.40mm_HandSolder
R52, R55: 2K2; R_0805_2012Metric_Pad1.20x1.40mm_HandSolder
R54: 220R; R_0805_2012Metric_Pad1.20x1.40mm_HandSolder
R58: 330R; R_0603_1608Metric_Pad0.98x0.95mm_HandSolder
SW1, SW3: SPST2P; SPST-7.3x3.9x2.5-WUERTH-434121025816
TP1: TP5V; TestPoint_Pad_D2.0mm
U2: ICE40UP5K-SG48ITR; QFN-48-1EP_7x7mm_P0.5mm_EP5.6x5.6mm
U3, U4, U6, U19: 74LVC4245APW_118; IC_74LVC4245_SOP65P640X110-24N
U5: IC74HC00; SOIC-14_3.9x8.7mm_P1.27mm
U7: ESP32-S3FN8; IC_ESP32-S3FN8-QFN40P700X700X90-57N
U8: 74CBTLV3126PW,118; TSSOP-14_4.4x5mm_P0.65mm
U9: CD4011B; SOIC-14_3.9x8.7mm_P1.27mm
U10: W25Q16JVSNIQ; SOIC-8_3.9x4.9mm_P1.27mm
U11: WM8524CGEDT; TSSOP-16_4.4x5mm_P0.65mm
U12: USBCH340C; SOIC-16_3.9x9.9mm_P1.27mm
U13: AMS1117-3.3; SOT-223-3_TabPin2
U14: AMS1117-1.2; SOT-223-3_TabPin2
U15: L7805; TO-252-2
U17, U18: MAX40200AUK; SOT-23-5
U23: SN74HCT04DR; SOIC-14_3.9x8.7mm_P1.27mm
U24, U25: SN74LVC00; TSSOP-14_4.4x5mm_P0.65mm
U26, U27: SN74LVC1G07DBVR; SOT-23-5
X1: OT3EL89CJI-111YLC-25M; OSC_ECS-2033-250-BN
Y2: 40.000Mhz; Crystal_SMD_2520-4Pin_2.5x2.0mm
mIOSEL1: TestPoint; TestPoint_Pad_D2.0mm

Connections:
1V2: C7.1, C8.1, C43.1, C51.1, C60.1, U2.5, U2.29, U2.30, U14.2
3V3: C1.2, C3.2, C4.1, C5.1, C6.1, C9.2, C11.2, C13.1, C14.1, C17.1, C18.1, C19.1, C20.1, C21.1, C22.1, C23.2, C24.2, C26.1, C27.1, C28.1, C29.1, C34.1, C35.1, C45.1, C46.1, C58.2, C59.2, C63.2, C67.1, C68.1, C69.1, C70.1, J1.4, J1.16, J3.4, JP3.1, L1.1, LD2.2, LD4.2, R7.2, R31.1, R32.1, R33.1, R34.2, R35.1, R36.2, R37.1, R38.1, R39.1, R40.1, R41.1, R43.1, R44.1, R49.2, R53.2, R59.2, R60.1, R61.1, R62.1, R63.1, R65.2, R71.1, U2.1, U2.22, U2.24, U2.33, U3.23, U3.24, U4.23, U4.24, U5.14, U6.23, U6.24, U7.20, U7.29, U7.46, U7.55, U7.56, U8.14, U9.14, U10.8, U11.6, U11.15, U13.2, U19.23, U19.24, U24.5, U24.14, U25.14, U26.5, U27.5, X1.4
5V: C2.2, C10.2, C12.2, C37.1, C44.1, C50.1, C57.1, C62.2, J1.9, J1.15, J2.9, J8.25, JP1.1, LD3.2, R47.2, R69.1, TP1.1, U3.1, U3.2, U4.1, U4.2, U6.1, U6.2, U12.16, U13.3, U14.3, U17.5, U18.5, U19.1, U23.14
/BusDecoder/B: U25.3, U25.5
/BusDecoder/VDD3P3: C15.1, C16.1, L1.2, U7.2, U7.3
/BusDecoder/a1: U24.8, U25.1
/BusDecoder/a2: U24.11, U25.2
/BusDecoder/n1: U24.3, U24.9, U24.10
/BusDecoder/n2: U24.6, U24.12, U24.13
/PowerSupply/D+: J4.6, J4.7, U12.5
/PowerSupply/D-: J4.5, J4.8, U12.6
/Vera FPGA flash/CLK: J3.5, R42.1, U8.8
/Vera FPGA flash/CMD: J3.3, R37.2, U8.6
/Vera FPGA flash/DAT0: J3.7, R40.2, U8.11
/Vera FPGA flash/DAT1: J3.8, R41.2
/Vera FPGA flash/DAT2: J3.1, R39.2
/Vera FPGA flash/DAT3: J3.2, R38.2, U8.3
/Vera FPGA flash/FLASH_SSEL_N: U9.11, U10.1
/Vera FPGA flash/SD_SSEL_N: U8.2, U9.10
A0: J8.2, U4.3
A1: J8.3, U4.4
A2: J8.4, U4.5
A3: J8.5, U4.6
A4: J8.6, U4.7
A5: J8.7, U4.8
A6: J8.8, U4.9
A7: J8.9, U4.10
A8: J8.10, U3.3
A9: J8.11, U3.4
A10: J8.12, U3.5
A11: J8.13, U3.6
A12: J8.14, U3.7
A13: J8.15, U3.8
A14: J8.16, U3.9
A15: J8.17, U3.10
ASYSCLK: R4.1, U11.10
AUD1L: J1.11, J7.3, R67.1
AUD1R: J1.12, J7.2, R68.1
AUDIO_BCK: U2.38, U11.9
AUDIO_DATA: U2.42, U11.7
AUDIO_LRCK: U2.43, U11.8
BOOT0: C61.1, R33.2, R54.1, SW3.2, U7.5
D0: J8.49, U19.3
D1: J8.48, U19.4
D2: J8.47, U19.5
D3: J8.46, U19.6
D4: J8.45, U19.7
D5: J8.44, U19.8
D6: J8.43, U19.9
D7: J8.42, U19.10
ESP32_CH340_RXD: D3.2, R48.2, R49.1, U7.50
ESP32_CH340_TXD: D4.1, U7.49
FPGA_CDONE: J6.2, JP2.2, Q1.1, R63.2, U2.7, U7.44, U8.1, U8.4, U8.10, U8.13, U9.1, U9.2, U9.8
GND: C1.1, C2.1, C3.1, C4.2, C5.2, C6.2, C7.2, C8.2, C9.1, C10.1, C11.1, C12.1, C13.2, C14.2, C15.2, C16.2, C17.2, C18.2, C19.2, C20.2, C21.2, C22.2, C23.1, C24.1, C25.2, C26.2, C27.2, C28.2, C29.2, C30.2, C31.2, C33.2, C34.2, C35.2, C36.2, C37.2, C38.2, C40.2, C42.2, C43.2, C44.2, C45.2, C46.2, C47.2, C48.2, C49.2, C50.2, C51.2, C52.2, C57.2, C58.1, C59.1, C60.2, C61.2, C62.1, C63.1, C64.1, C65.1, C67.2, C68.2, C69.2, C70.2, J1.5, J1.6, J1.7, J1.8, J1.10, J2.5, J2.6, J2.7, J2.8, J2.10, J3.6, J4.1, J4.12, J5.2, J6.8, J7.1, J8.26, JP2.1, Q1.2, R2.2, R5.1, R42.2, R50.2, R51.2, R57.2, R58.2, R64.2, R70.1, R72.2, R73.2, R74.2, SW1.1, SW3.1, U2.49, U3.11, U3.12, U3.13, U4.11, U4.12, U4.13, U5.7, U5.12, U5.13, U6.11, U6.12, U6.13, U7.57, U8.7, U9.7, U10.4, U11.4, U11.13, U12.1, U13.1, U14.1, U15.2, U17.2, U18.2, U19.11, U19.12, U19.13, U23.3, U23.5, U23.7, U23.9, U23.11, U23.13, U24.7, U25.7, U25.9, U25.10, U25.12, U25.13, U26.3, U27.3, X1.2, Y2.2, Y2.4
unnamed: C30.1, R46.1, R68.2
unnamed: C31.1, R45.1, R67.2
unnamed: C32.1, U11.5
unnamed: C32.2, U11.3
unnamed: C33.1, U11.2
unnamed: C36.1, U11.14
unnamed: C38.1, R48.1, U12.4
unnamed: C40.1, J4.2, J4.11, U18.1, U18.3
unnamed: C42.1, J4.S1, J4.S2, J4.S3, J4.S4, J4.S5, J4.S6
unnamed: C47.1, J5.1A, J5.1B, U15.1
unnamed: C48.1, C49.1, R56.2, U15.3
unnamed: C52.1, J3.SH
unnamed: C64.2, U7.53, Y2.3
unnamed: C65.2, L2.2, Y2.1
unnamed: D3.1, U12.2
unnamed: D4.2, R47.1, U12.3
unnamed: J4.3, R50.1
unnamed: J4.9, R51.1
unnamed: J6.1, JP1.2, JP3.2
unnamed: J8.23, J8.28
unnamed: J8.24, J8.27
unnamed: L2.1, U7.54
unnamed: LD1.2, R32.2
unnamed: LD2.1, R1.1
unnamed: LD3.1, R57.1
unnamed: LD4.1, R58.1
unnamed: LD5.2, R61.2
unnamed: Q1.3, R1.2
unnamed: Q3.1, R52.1
unnamed: Q3.2, R55.2, U12.14
unnamed: Q4.1, R55.1
unnamed: Q4.2, R52.2, U12.13
unnamed: Q4.3, R54.2
unnamed: R2.1, U6.9
unnamed: R3.2, R4.2, X1.3
unnamed: R11.1, R12.2
unnamed: R13.1, R14.2
unnamed: R15.1, R16.2
unnamed: R17.1, R18.2
unnamed: R19.1, R20.2
unnamed: R21.1, R22.2
unnamed: R23.1, R24.2
unnamed: R25.1, R26.2
unnamed: R27.1, R28.2
unnamed: R35.2, U11.11, U11.12
unnamed: R43.2, U10.3
unnamed: R44.2, U10.7
unnamed: R45.2, U11.1
unnamed: R46.2, U11.16
unnamed: R56.1, U17.1, U17.3
unnamed: R64.1, U6.22
unnamed: R71.2, U7.8
unnamed: R72.1, U6.4
unnamed: R73.1, U6.5
unnamed: R74.1, U6.10
unnamed: U5.4, U5.8
unnamed: U9.3, U9.12
unnamed: U9.4, U9.9, U9.13
unnamed: U19.2, U23.2
PHI0: J8.40, U6.7
RST\EN: C25.1, Q3.3, R31.2, SW1.2, U7.4
R~W: J8.18, R69.2, U6.6, U23.1
SPI_MISO: J6.4, U2.17, U8.12, U10.2
SPI_MOSI: J6.5, U2.14, U8.5, U10.5
SPI_SCK: J6.6, U2.15, U8.9, U10.6
SPI_SSEL_N: J6.7, R62.2, U2.16, U9.5, U9.6
VGABLUE: J1.3, J2.3, R8.1, R12.1, R18.1, R24.1
VGAGREEN: J1.2, J2.2, R9.1, R14.1, R20.1, R26.1
VGAHSYNC: J1.13, J2.13, R29.1
VGARED: J1.1, J2.1, R10.1, R16.1, R22.1, R28.1
VGAVSYNC: J1.14, J2.14, R30.1
VGA_B0: R8.2, U2.46
VGA_B1: R11.2, U2.47
VGA_B2: R17.2, U2.48
VGA_B3: R23.2, U2.2
VGA_G0: R9.2, U2.3
VGA_G1: R13.2, U2.4
VGA_G2: R19.2, U2.6
VGA_G3: R25.2, U2.9
VGA_HSYNC: R29.2, U2.44
VGA_R0: R10.2, U2.10
VGA_R1: R15.2, U2.11
VGA_R2: R21.2, U2.12
VGA_R3: R27.2, U2.13
VGA_VSYNC: R30.2, U2.45
VSYSCLK: R3.1, U2.35
mA0: U2.40, U4.21, U7.17
mA1: U2.39, U4.20, U7.18
mA2: U2.37, U4.19, U7.19
mA3: U2.41, U4.18, U7.21
mA4: U2.34, U4.17, U7.22
mA5: U4.16, U7.23
mA6: U4.15, U7.24
mA7: U4.14, U7.25
mA8: U3.21, U7.26
mA9: U3.20, U7.27
mA10: U3.19, U7.38
mA11: U3.18, U7.39
mA12: U3.17, U7.40
mA13: U3.16, U7.41
mA14: U3.15, U7.51
mA15: U3.14, U7.52
mD0: U2.27, U7.9, U19.21
mD1: U2.26, U7.10, U19.20
mD2: U2.25, U7.11, U19.19
mD3: U2.23, U7.12, U19.18
mD4: U2.21, U7.13, U19.17
mD5: U2.20, U7.14, U19.16
mD6: U2.19, U7.15, U19.15
mD7: U2.18, U7.16, U19.14
mPHI0: U5.1, U5.5, U6.17, U7.6, U25.4
mR~W: U5.2, U5.9, U5.10, U6.18, U7.7, U24.1
~ABUS_OE: R7.1, R34.1, U3.22, U4.22, U7.37
~DEVSEL: J8.41, U6.8
~FPGA_RESET: J6.3, R5.2, U2.8, U7.43
~IOSEL: J8.1, U6.3
~IRQ: J8.30, U26.4
~OE: U19.22, U25.6
~RES: J8.31, U27.4
~mCARD_RD: R53.1, U7.47, U24.4
~mDEVSEL: LD1.1, R65.1, U6.16, U7.48
~mIOSEL: LD5.1, U6.21, U7.36, mIOSEL1.1
~mRE: R59.1, U2.36, U5.3
~mRESET: R70.2, U7.42, U27.2
~mVCS0: R36.1, U2.28, U7.45, U24.2
~mVIRQ: U2.32, U26.2
~mWE: R60.2, U2.31, U5.6
