gianlucarenzi/Vera-Module-RBL-A2/VGA-Extender/VGA-Extender.kicad_pcb

## KiCad design VGA-Extender/VGA-Extender.kicad_pcb (2026-11-12)

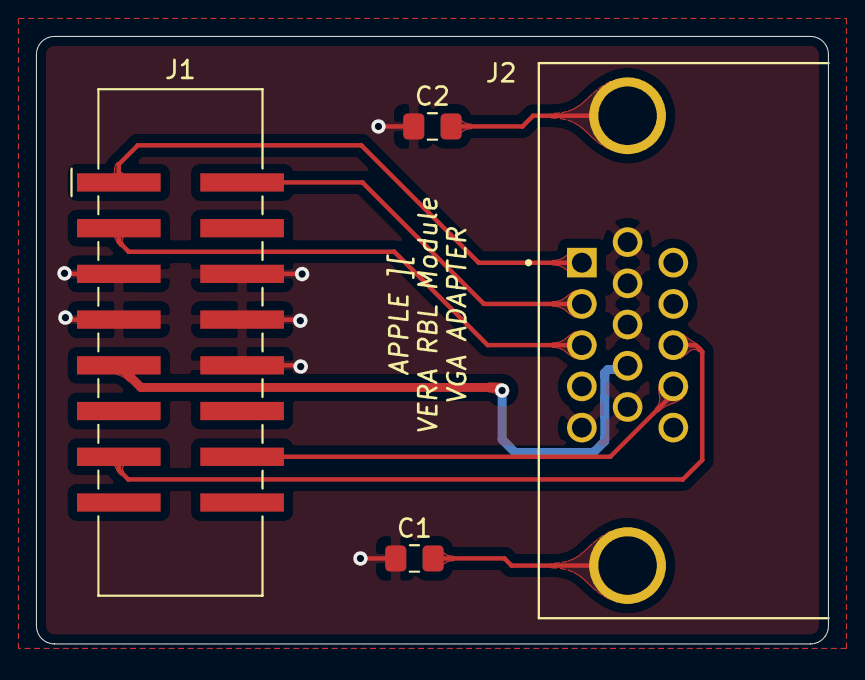
[picture p20: board VGA-Extender.kicad_pcb from above]

Board: 2 copper layers, 44.0 x 33.8 mm, 4 parts (0 on the bottom side), 9 nets.

Parts:
C1, C2: 100nF; C_0805_2012Metric_Pad1.18x1.45mm_HandSolder
J1: CONN_SMD_HEADER_BOX_02x08_HX-JN2.54; IDC-Header_2x08_P2.54mm_Vertical_SMD
J2: DS1038-15FBNSiA74-0CC; CONNFLY_DS1038-15FBNSIA74-0CC

Connections:
+5V: J1.9, J2.9
GND: C1.1, C2.1, J1.5, J1.6, J1.7, J1.8, J1.10, J2.5, J2.6, J2.7, J2.8, J2.10
unnamed: C1.2, J2.S1
unnamed: C2.2, J2.S2
VGABLUE: J1.3, J2.3
VGAGREEN: J1.2, J2.2
VGAHSYNC: J1.13, J2.13
VGARED: J1.1, J2.1
VGAVSYNC: J1.14, J2.14
