gianlucarenzi/Vera-Module-RBL-A2/(commit log)

2026-11-12 Import VERA Module RBL-XE (Atari) at ef5d3cc as the base of the Apple II port
    Files as in Vera-Module-RBL-XE commit ef5d3cc (tools: fastroute scripts
    independent of the board); the Apple II work starts from here.
    [VERA-MODULE-RBL-B_Cu.gbl, VERA-MODULE-RBL-B_Mask.gbs, VERA-MODULE-RBL-B_Paste.gbp, VERA-MODULE-RBL-B_SilkS.gbo, VERA-MODULE-RBL-Edge_Cuts.gm1, VERA-MODULE-RBL-F_Cu.gtl, VERA-MODULE-RBL-F_Mask.gts, VERA-MODULE-RBL-F_Paste.gtp]
2026-11-12 Apple II slot card: Slinky-compatible 256 KB RAM disk, ProDOS out of the box
    The ESP32 serves an Apple II Memory Expansion Card ("Slinky") at
    $C0n0-$C0n3 of its slot (registers as MAME's a2memexp: 24-bit address with
    auto-increment, $C0n2 reads OR $F0, $C0n4-$C0nF plain registers) and a
    position-independent ProDOS slot ROM at $Cn00-$CnFF, so ProDOS finds the
    RAM disk /SLINKY at boot without a driver.
    - After an Apple reset the ROM answers $Cn00-$Cn1F; $C0nF bit 0 = 1 puts
    the VERA registers there. The ProDOS driver lies at $Cn33, above the
    VERA window, so it keeps working with the VERA in.
    - 256 KB in the ESP32's DRAM, formatted as an empty ProDOS volume at
    power-on; reset clears the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
    [main.cpp]
2026-11-12 Remove the Atari design: Apple II slot card only
    - Removed the Atari board design data (schematic sheets, PCB, netlist, BOM,
    Gerber/drill output, interactive BOM, renders, DXF/SVG outline): the Apple
    II board is to be drawn from scratch.
    - Removed the Atari firmware: PBI/CCTL bus decode and its test, PBI 6502
    driver ROMs, the interface FPGA (RAMbo on external SRAM), the timing thesis,
    the Atari analysis and log, the Atari hardware requirements and session
    notes.
    - README.md, PIN-MAPPING.md, firmware/MCU/README.md rewritten for the Apple
    II card; A2-SLINKY.md states the board requirements on their own.
    - Production scripts kept for the board to come: output name -A2,
    output fold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
    [VERA-MODULE-RBL-B_Cu.gbl, VERA-MODULE-RBL-B_Mask.gbs, VERA-MODULE-RBL-B_Paste.gbp, VERA-MODULE-RBL-B_SilkS.gbo, VERA-MODULE-RBL-Edge_Cuts.gm1, VERA-MODULE-RBL-F_Cu.gtl, VERA-MODULE-RBL-F_Mask.gts, VERA-MODULE-RBL-F_Paste.gtp]
2026-11-12 Restore the board design files from 141100c
    The Apple II board reuses the RBL-XE design: same schematic and PCB with
    another bus connector and board outline. Schematic sheets, project, PCB,
    netlist and BOM back as in the import commit; the Apple II slot interface
    follows in the next commit.
    [VERA-MODULE-RBL.csv, VERA-MODULE-RBL.kicad_pcb, VERA-MODULE-RBL.sch, busdecoder.sch, cartridgeInterface.sch, powersupply.sch, vera-fpga-flash.sch, vera-fpga.sch]
2026-11-12 Schematic: Apple II slot interface in place of the Atari cartridge/ECI
    cartridgeInterface.sch becomes a2slotInterface.sch:
    - J8 Bus_Apple_II_Card_Side (2x25 card edge, RetroBitLab) in place of
    CART1 and ECI1: A0-A15, D0-D7, R/W, PHI0, /DEVSEL, /IOSEL, /IRQ, /RES,
    +5V, GND; INT and DMA daisy chains passed through (28->23, 27->24); the
    other pins not connected.
    - /RES driven by U27 SN74LVC1G07 (open drain, copy of the U26 IRQ stage)
    from GPIO37; R70 pulls its input down, so the Apple stays in reset until
    the firmware releases it. The Apple /RES is a wired-OR line with a
    pull-up: a push-pull driver would fight the RESET key.
    - U6: /IOSEL on channel 0 (GPIO48, LED LD5, test point mI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
    [VERA-MODULE-RBL.sch, a2slotInterface.sch, busdecoder.sch]
2026-11-12 Schematic: ERC power conflicts on J8 fixed, layout touch-ups
    - J8 power pins are passive now (RetroBitLab b975c2c): with the power
    outputs of the old symbol, eeschema reported J8 +5V/GND against the
    PWR_FLAGs #FLG0101/#FLG0105 and against U6 inputs tied to GND.
    - PWR_FLAG #FLG0109 removed: GND is already flagged by #FLG0105.
    - U6 unused inputs A1, A2, A6 to GND through 0 ohm resistors (R72, R73,
    R2), like A7 (R74): no bidirectional pin directly on GND, and each
    channel can be reused by removing its resistor.
    - Layout: J8 no-connect flags on short wire stubs, GND symbol beside J8,
    labels and notes moved, root sheet title on three lines.
    kicadcli: no connection change apart from the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
    [VERA-MODULE-RBL.sch, a2slotInterface.sch]
2026-11-12 PCB: Edge.Cuts from Apple IIgs Tech Note #28 (slots 1-3)
    Board outline redrawn to the Apple interface card guidelines, which
    also hold for the Apple IIe:
    - 7.00" (177.8 mm) long, 2.75" (69.85 mm) above the slot
    - tab front edge 2.950" (74.93 mm) from the rear (right) edge
    - body starts right above the edge fingers: the T-shaped neck is gone
    - rear and top edges unchanged, so the H1-H4 references still hold
    J8 moved to (233.463, 120.525). Margin dimensions updated.
    Also carries the unrouted board state saved from pcbnew before this
    change. The components still have to be placed inside the new outline.
    [VERA-MODULE-RBL.kicad_pcb]
2026-11-12 docs: IIgs Tech Note #28, Apple II card templates, links to the IIe manuals
    - Apple IIgs Tech Note #28 "Interface Card Design Guidelines": the card
    dimensions used for the Edge.Cuts (they also hold for the Apple IIe)
    - con-apple2.lbr: Eagle Apple II card templates derived from TN #28,
    used to read the dimensions that are cut off in the scanned note
    - README.md: sources, and download links for the Apple IIe Technical
    Reference Manual (139 MB, not stored) and the Apple IIe Tech Notes
2026-11-12 VGA-Extender: add the VGA adapter sub-project
    [VGA-Extender.kicad_pcb, VGA-Extender.sch]
2026-11-12 Schematic: layout touch-ups, netlist regenerated for the Apple II card
    - a2slotInterface.sch, busdecoder.sch, vga-analog.sch: symbols, labels
    and wires rearranged (U23, mIOSEL1, ...)
    - VERA-MODULE-RBL.net regenerated: it still described the Atari design
    (CART1, ECI1, ~HALT1, ...); now 201 components with J8 (Apple II slot
    edge connector), U27, C70 and mIOSEL1
    [a2slotInterface.sch, busdecoder.sch, vga-analog.sch]
2026-11-13 Routing: no time limits, POWER-layer fallback, USB pair at 0.200 mm
    - tools/route_nolimits.sh WORKDIR: the whole from-scratch routing in one
    go, to rerun as is on any PC: tools/route.sh, then (when connections
    are left) tools/route_power_fallback.sh
    - tools/fastroute_nolimits.sh: fastroute wrapper (FASTROUTE=...) with no
    time limit: every --max-time becomes 10 years, --no-time-limits drops
    the job timeout (12 h by default, 24 h at most)
    - tools/route_power_fallback.sh: stage 3 from the stage 2 session, with
    POWER routable at 25x the trace cost of the outer layers; the 3V3 plane
    stays (planes of signal layers are not obstacles), GND is never cut.
    Lists the POWER traces in mm, to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
    [diff_pairs.txt]
2026-11-13 Routing: tools/chamfer_ses.py, no 90 degree bends on the same layer
    Cuts every 90 degree bend of a Specctra session with a 45 degree segment
    (0.5 mm per leg by default, less where there is no room), checking the
    clearance to the traces, vias and pads of the other nets. Bends on a via
    or a pad stay (a change of direction through a via is allowed); the ones
    with no room are listed in mm to fix by hand.
    Checked on a 21-unrouted session: same 40 pre-existing violations and
    same 21 unrouted connections after the chamfer, 72 bends chamfered, 21
    left. WORKFLOW.md, section 7: when to run it.
2026-11-13 Routing: chamfer the 90 degree bends at the end of route.sh and of the POWER fallback
2026-11-13 Routing: repair the clearance violations after routing
    - tools/ses_violations.py: sorts the violations of a fastroute report by
    the copper found at each point (nets from the session and the DSN):
    same net and rounding (within 0.002 mm) ignored, real ones with a
    movable trace or via ripped up, real ones between fixed items listed
    - tools/repair_violations.sh DSN in.ses out.ses [ROUNDS]: measure, rip,
    reroute with fastroute, dedupe and chamfer; a round is kept only if
    the real violations go down and the unrouted connections do not go up
    Tried on the first-run session (its own tracks made movable): 5 real
    violations -> 0, but with a 600 s reroute limit 6 more connections were
    left un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
2026-11-13 Routing: from-scratch result, violation repair in route_nolimits.sh
    - routing/: the result of tools/route_nolimits.sh on the placement of
    this PCB (final.ses, the DSN used, reports and logs, README): 604
    connections, 6 unrouted, 0 clearance violations; the POWER fallback did
    not help (still 6), so no traces on POWER; USB pair coupled for 13.24
    of 39.77 mm, length difference 0.05 mm; 30 bends of 90 degrees left
    - tools/route_nolimits.sh: runs tools/repair_violations.sh last
    (REPAIR=0 skips it), result WORKDIR/final_repaired.ses
    - route.sh, route_power_fallback.sh, repair_violations.sh: FASTROUTE
    made absolute before changing directory (a relative path failed)
    [board_pv.dsn]
2026-11-13 PCB: component placement and zones used for routing; schematic and netlist updates
    [VERA-MODULE-RBL.csv, VERA-MODULE-RBL.kicad_pcb, a2slotInterface.sch, busdecoder.sch]
2026-11-14 generate_ibom.py: also accept the KiCad plugin folder layout
    ~/.kicad/scripting/plugins/InteractiveHtmlBom can be a git clone (package
    in InteractiveHtmlBom/) or the package itself, as KiCad installs it; the
    second one made output_job.sh stop at the interactive BOM.
2026-11-14 PCB finished: routing completed; v0.1 outputs (iBOM, PDF, images, 3D models)
    [VERA-MODULE-RBL.csv, VERA-MODULE-RBL.kicad_pcb, VERA-MODULE-RBL.sch, VERA-MODULE-RBL.step, a2slotInterface.sch, busdecoder.sch, powersupply.sch, vera-fpga-flash.sch]
2026-11-14 output_job.sh: BOM XML made by kicadcli, as in ESP32-BOBOARD-5V
    utilities/kicadcli (from ESP32-BOBOARD-5V) makes the XML from the KiCad 5
    schematic, installed into ~/bin when missing or different from the copy
    of the project. Its export-xml now stops on a part without annotation or
    on two different parts with the same reference, as sch2bomxml.py did:
    without it a wrong BOM came out with no error.
    sch2bomxml.py removed; same JLCPCB BOM as before. Also in
    check_jlcpcb_stock.sh and WORKFLOW.
    [VERA-MODULE-RBL.csv]
2026-11-14 Schematic: U12 CH340T -> CH340C (LCSC C84681), crystal removed
    The CH340T (C8689) is out of stock at JLCPCB. The CH340C has the same
    signals and an internal clock: Y1 (12 MHz), C39 and C41 are removed with
    their wires; the CKOL and NOS# wires and no-connect flags go too, OUT#
    (pin 8) stays unconnected and pin 7 (NC) open as the datasheet requires.
    Footprint RetroBitLab:SOIC-16_3.9x9.9mm_P1.27mm. Same nets on U12 and
    same ERC messages as before. The PCB still has to be updated.
    Also jlcpcb-global-sourcing.txt as in XE and C64: U11 WM8524 (C146242)
    through JLCPCB Global Sourcing.
    [powersupply.sch]
2026-11-14 PCB: U12 CH340C (SOIC-16), crystal Y1, C39 and C41 removed
    Netlist updated from the schematic; U12 routed again. Checked: 0
    differences between PCB and schematic, 0 unconnected in the ratsnest,
    no orphan tracks or vias.
    [VERA-MODULE-RBL.kicad_pcb]
2026-11-14 Docs: new README, FPGA programming with iceprog; v0.2 outputs
    - README: what it can look like (illustrative mock-ups of two original demo
    games, IRONHOLD and CIRCUIT RUNNER, drawn by tools/make_demo_shots.py, not
    captures from the board), what is new (CH340C, WM8524 through JLCPCB Global
    Sourcing, BOM XML by kicadcli)
    - FPGA programming with iceprog through J6: FT232H wiring, stop the ESP32
    first (its firmware drives CRESET), JP2 closed while writing; breadboard
    style drawing by tools/fpga_prog_diagram.py (images/fpga_programming_*.svg)
    - ESP32 flashing through the on-board CH340C on USB-C (UART0, DTR/RTS
    auto-reset), not an external UART adapter
    - WORKFLOW.pdf rebuilt from WORKF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
    [VERA-MODULE-RBL.csv, VERA-MODULE-RBL.step]
2026-11-14 Scripts: KiCad 5 from the system, otherwise from the AppImage
    KiCad 5 from the system when it is there, otherwise from the KiCad 5
    AppImage (kicad5):
    - pcbnew: kicadcli (now 1.2), run_pcbnew.sh and run_generate_cpl.sh take
    the system pcbnew only when it is version 5 (a KiCad 6+ pcbnew has
    another API), otherwise the AppImage one; kicadcli runs itself again with
    "kicad5 --python" for the pcb commands
    - eeschema symbols: kicadcli uses /usr/share/kicad/library when it holds the
    KiCad 5 libraries (power.lib), otherwise ~/.cache/kicad5/library, copied
    once from the AppImage; the eeplot library block of output_job.sh checks
    power.lib too
    - run_kicad5.sh PROGRAM: a KiCad 5 program (kica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
    [VERA-MODULE-RBL.step]
