gianlucarenzi/Vera-Module-RBL-A2/(notices)

Notices in the files:
README.md:
License: GPL v3
parts and their libraries:
From markadev/KiCad-AppleII 9c33c63 (CC BY-SA 4.0), converted to KiCad 5
